IotronicAcademy/WRO-Future-Engineers-Mex-2025/schemes/Esquemas/Presentación1_01.png

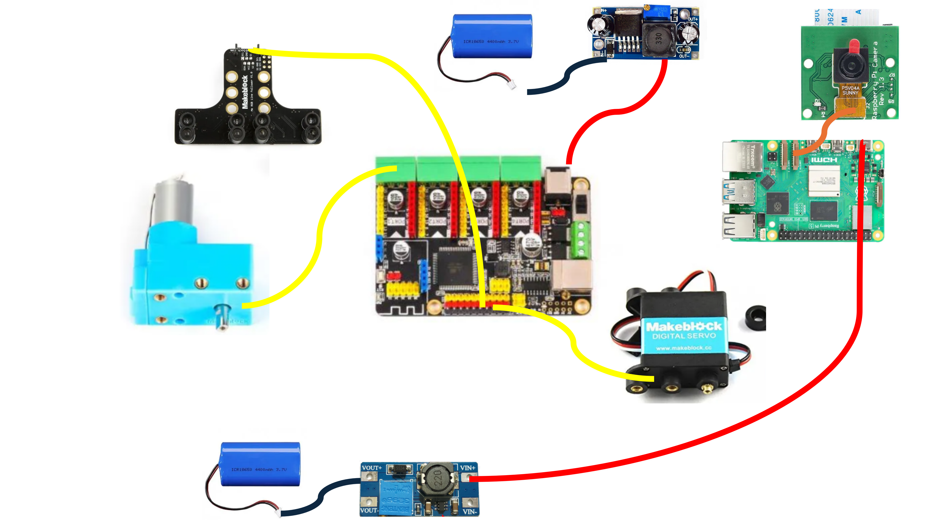
schemes/Esquemas/Presentación1_01.png
