IotronicAcademy/WRO-Future-Engineers-Mex-2025/t-photos/fun-team.jpg

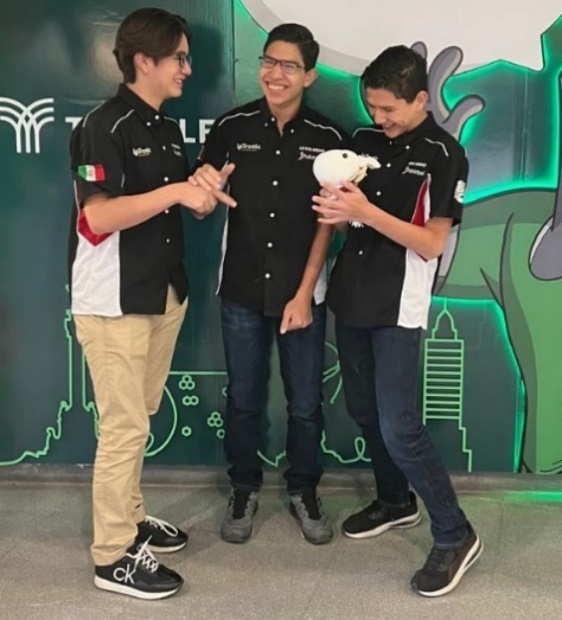
t-photos/fun-team.jpg
