IotronicAcademy/WRO-Future-Engineers-Mex-2025/t-photos/official-team.jpg

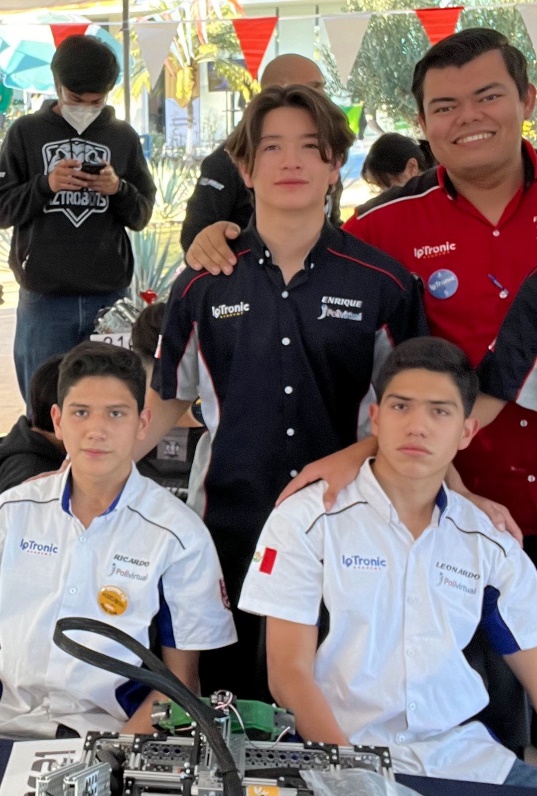
t-photos/official-team.jpg
