IotronicAcademy/WRO-Future-Engineers-Mex-2025/t-photos/team3.jpeg

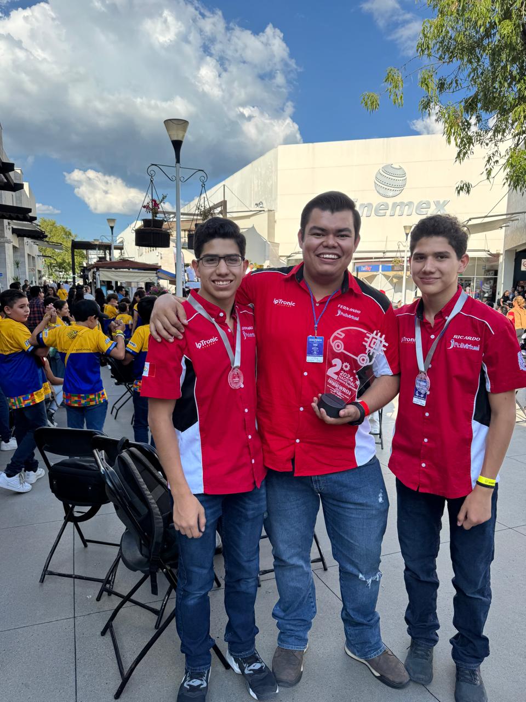
t-photos/team3.jpeg
