IotronicAcademy/WRO-Future-Engineers-Mex-2025/t-photos/team4.jpeg

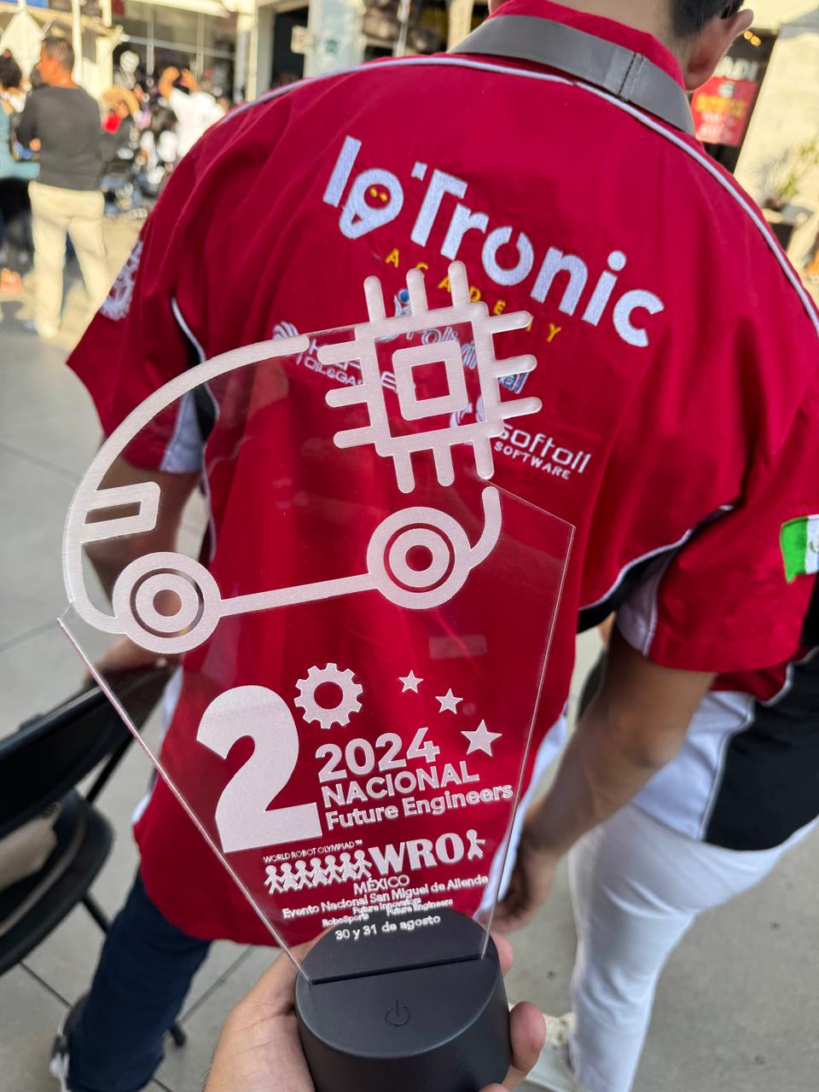
t-photos/team4.jpeg
