IotronicAcademy/WRO-Future-Engineers-Mex-2025/t-photos/team5.jpeg

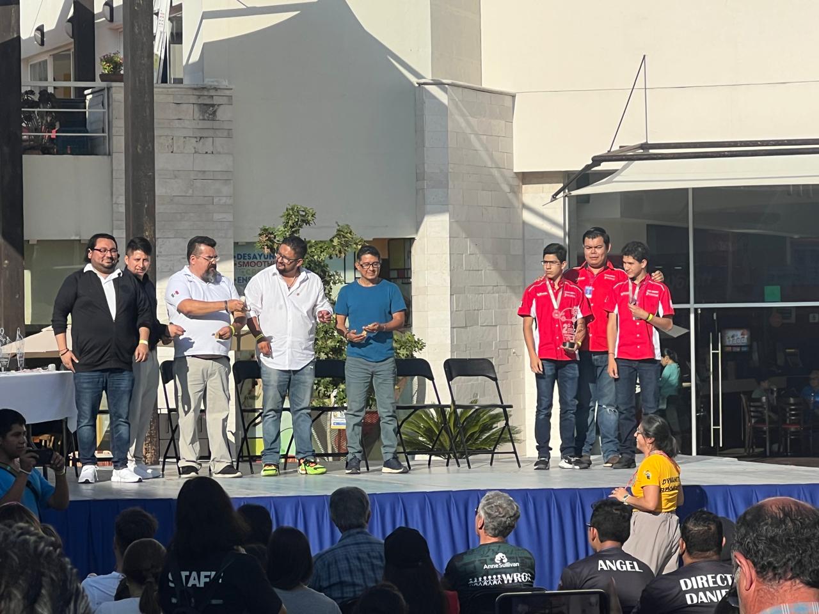
t-photos/team5.jpeg
