IotronicAcademy/WRO-Future-Engineers-Mex-2025/t-photos/team6.jpeg

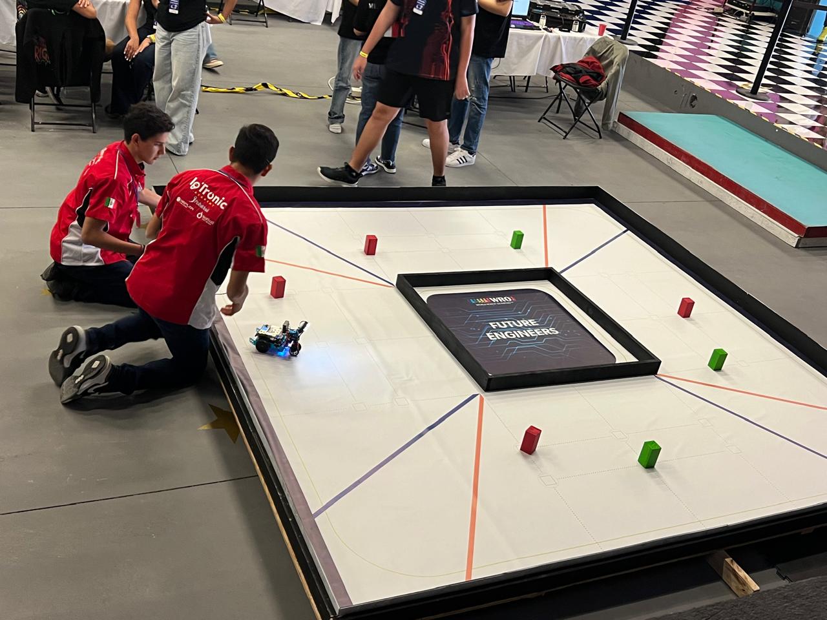
t-photos/team6.jpeg
