IotronicAcademy/WRO-Future-Engineers-Mex-2025/t-photos/team7.jpeg

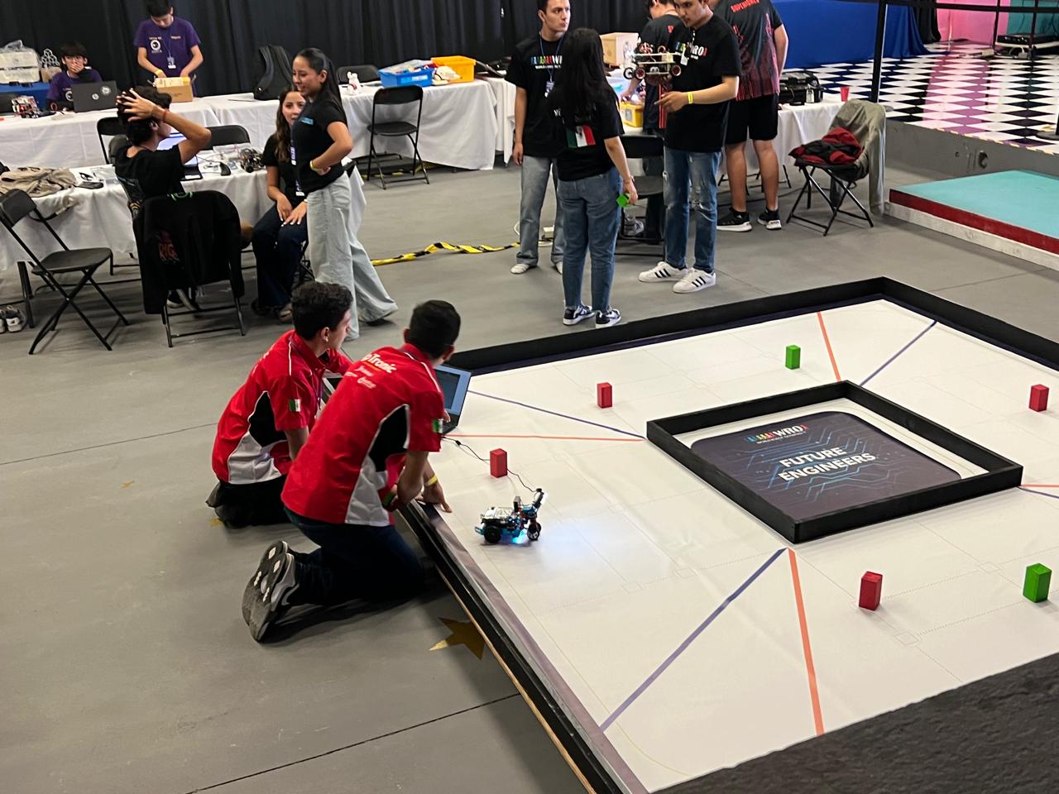
t-photos/team7.jpeg
