IotronicAcademy/WRO-Future-Engineers-Mex-2025/t-photos/team8.jpeg

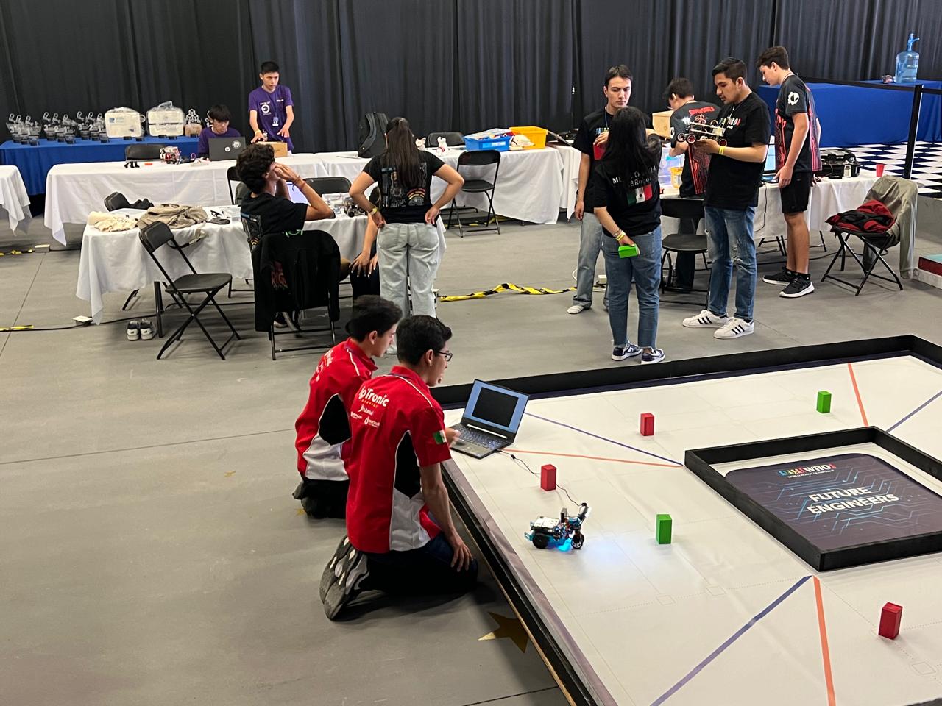
t-photos/team8.jpeg
