IotronicAcademy/WRO-Future-Engineers-Mex-2025/t-photos/team9.jpeg

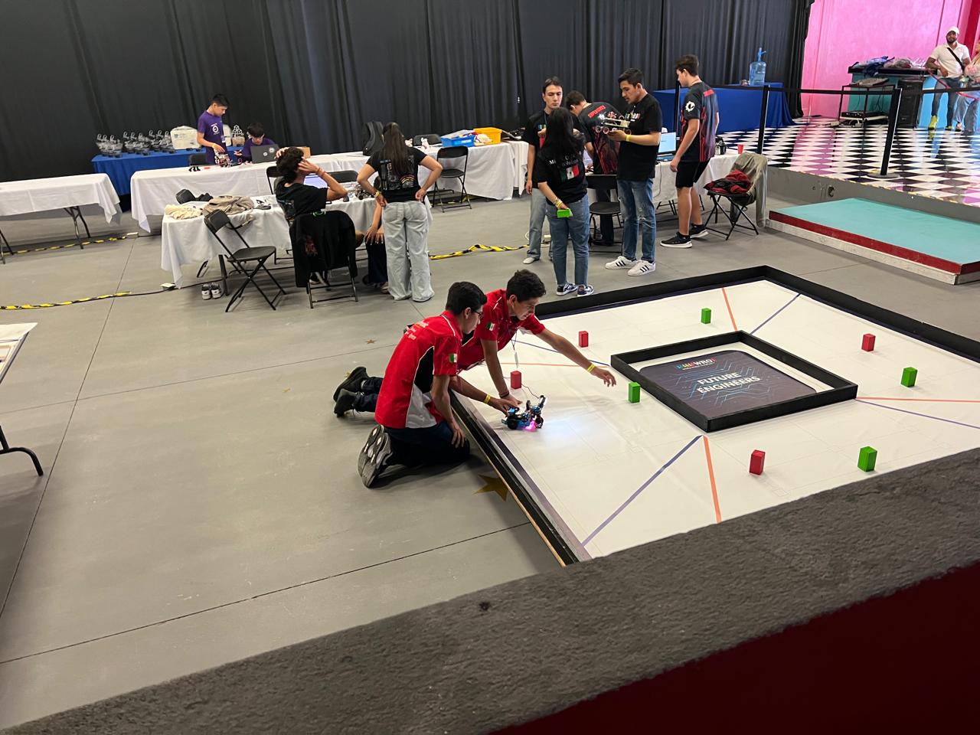
t-photos/team9.jpeg
