IotronicAcademy/WRO-Future-Engineers-Mex-2025/t-photos/team10.jpeg

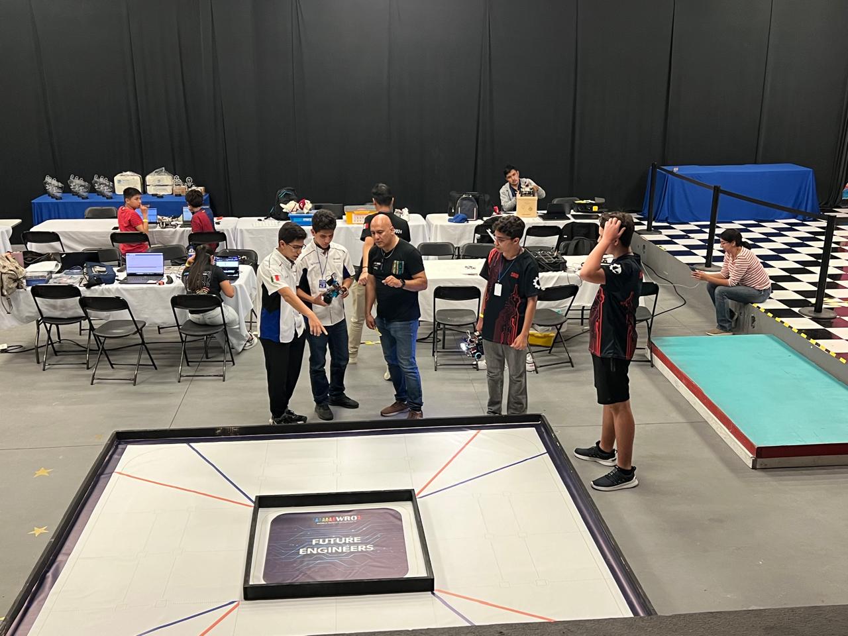
t-photos/team10.jpeg
