IotronicAcademy/WRO-Future-Engineers-Mex-2025/t-photos/team11 (1).jpeg

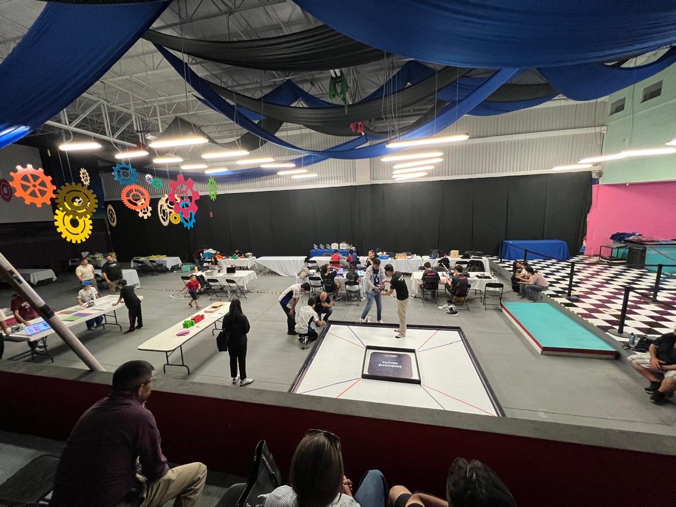
t-photos/team11 (1).jpeg
