IotronicAcademy/WRO-Future-Engineers-Mex-2025/t-photos/team11.jpeg

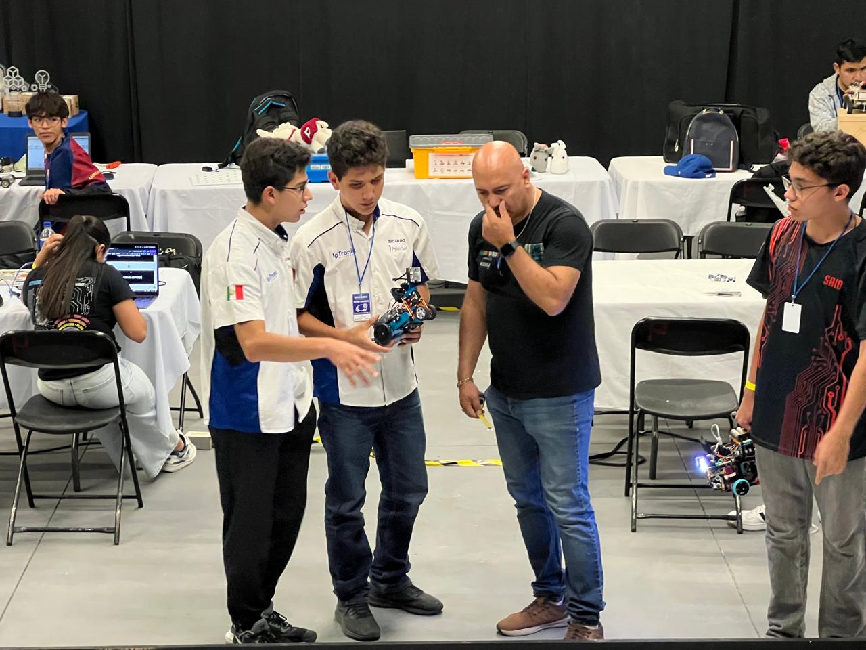
t-photos/team11.jpeg
