IotronicAcademy/WRO-Future-Engineers-Mex-2025/t-photos/team12.jpeg

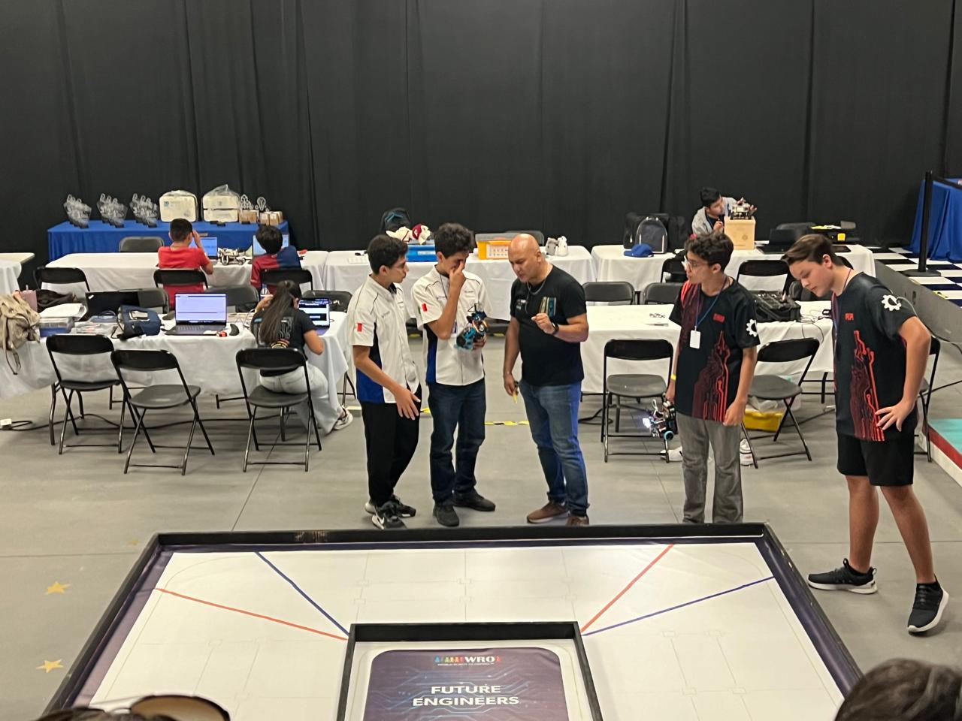
t-photos/team12.jpeg
