IotronicAcademy/WRO-Future-Engineers-Mex-2025/v-photos/Foto 2.jpg

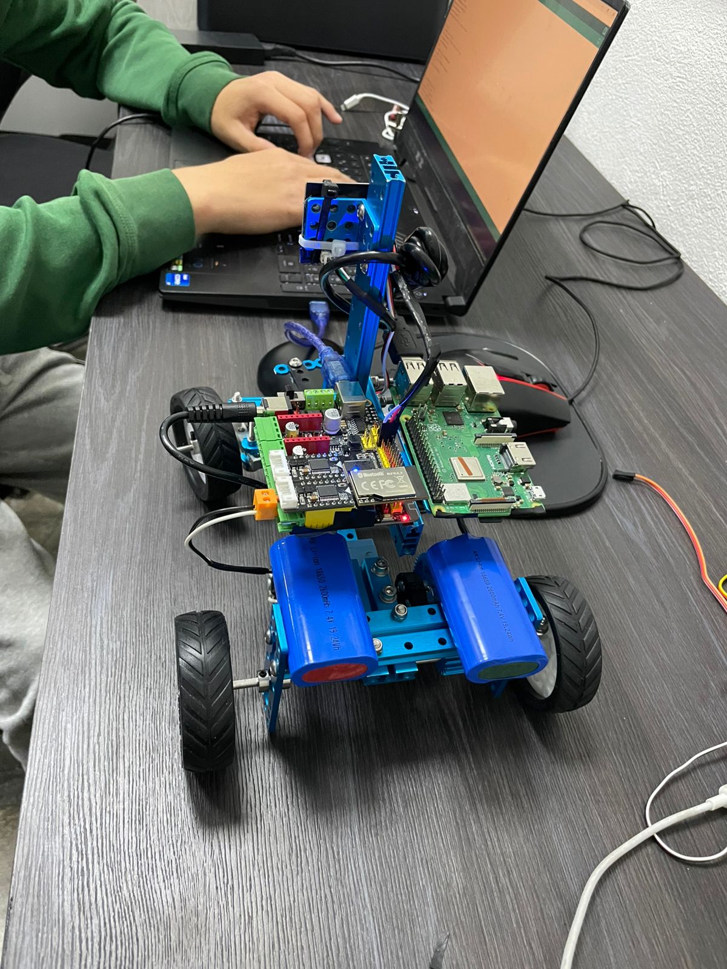
v-photos/Foto 2.jpg
