IotronicAcademy/WRO-Future-Engineers-Mex-2025/v-photos/Foto 3.jpg

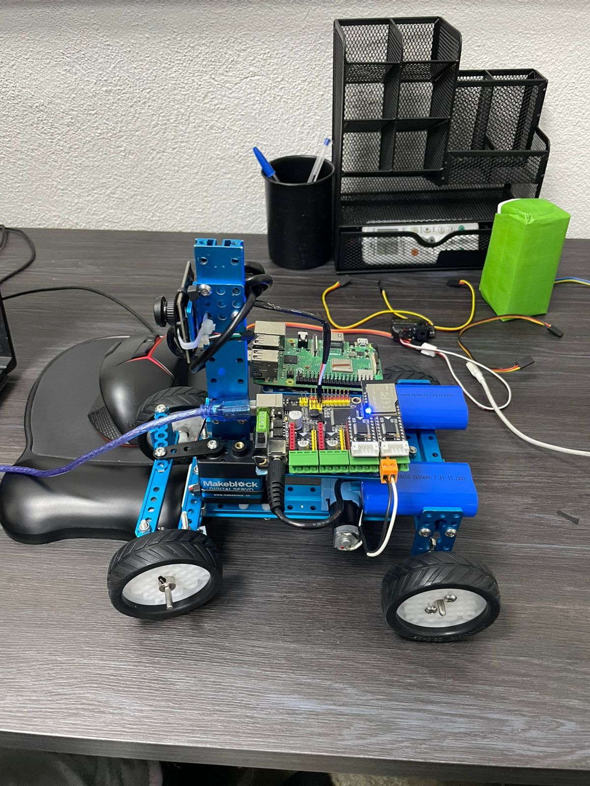
v-photos/Foto 3.jpg
