IotronicAcademy/WRO-Future-Engineers-Mex-2025/other/Engineering Journal/Engineering_Journal_IOTRONIC_Mexico_WRO_2025_RevF.pdf

TEAM: IoTronic Polivirtual - Leotronics ENGINEERING JOURNAL
WRO 2025
FUTURE ENGINEERS

SCHOOL: CECyT 9 IPN y Anáhuac Qro.

# ENGINEERING JOURNAL WORLD ROBOT OLYMPIAD FUTURE ENGINEERS

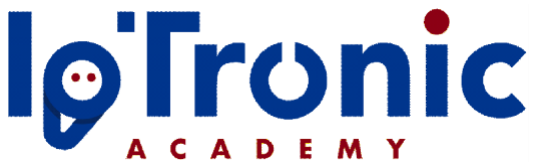
[picture p20: figure]

## TEAM NAME: IOTRONIC POLIVIRTUAL - LEOTRONICS

## TEAM CITY: QUERÉTARO, MÉXICO

## TEAM ACADEMY: IOTRONIC ACADEMY

TEAM SCHOOL: CECYT 9 IPN / ANÁHUAC QRO.

## COMPETITION PROGRAM: FUTURE ENGINEERS

## CAR NAME: GOAT L3 MEMBERS: 3

## ROSTER:

### - PROGRAMMER: LUIS RICARDO CHAVARRÍA ARREOLA - IPN

### - MECHANIC: LUIS LEONARDO CHAVARRÍA ARREOLA – IPN / ANÁHUAC

### - ELECTRONIC: LUIS ENRIQUE RAMÍREZ CHAVARRÍA - IPN

WRO 2025
FUTURE ENGINEERS

# TABLE OF CONTENTS

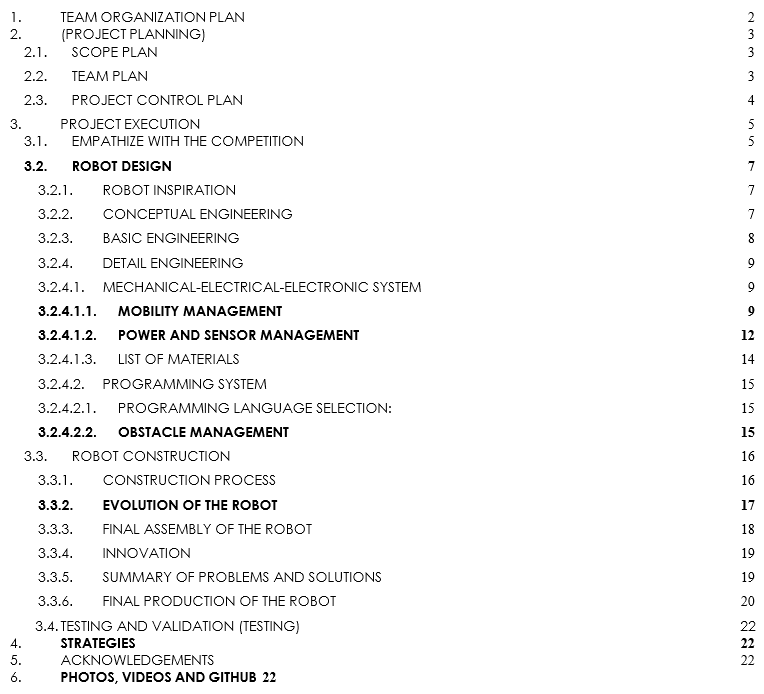
[picture p21: figure]
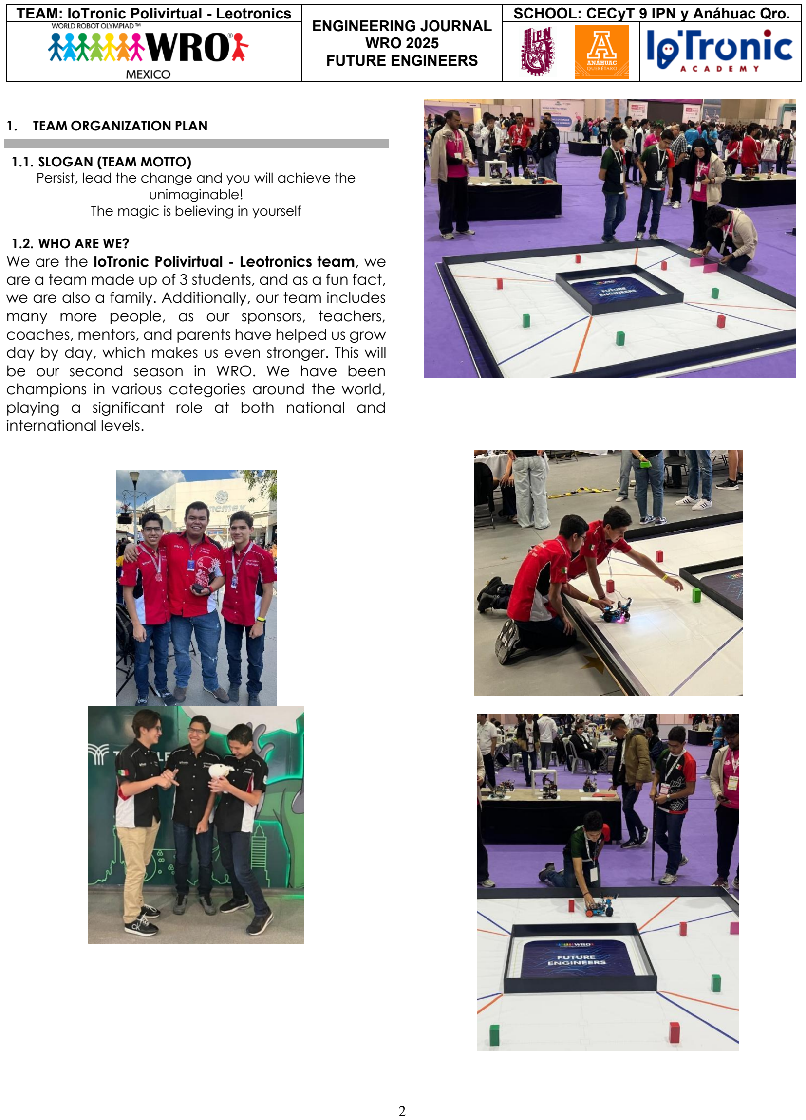
[picture p22: page 3]

WRO 2025
FUTURE ENGINEERS

### 1. TEAM ORGANIZATION PLAN

### 1.1. SLOGAN (TEAM MOTTO)

Persist, lead the change and you will achieve the unimaginable!
The magic is believing in yourself

### 1.2. WHO ARE WE?

We are the IoTronic Polivirtual - Leotronics team, we are a team made up of 3 students, and as a fun fact, we are also a family. Additionally, our team includes many more people, as our sponsors, teachers, coaches, mentors, and parents have helped us grow day by day, which makes us even stronger. This will be our second season in WRO. We have been champions in various categories around the world, playing a significant role at both national and international levels.

### 1.3. OBJECTIVES

Our objectives are:
- Learn: Learning is the number one foundation for achieving any objective, which is why we have studied, prepared ourselves, and acquired the tools to complement all our knowledge.
- Teach: We seek to teach others, especially about this world of STEAM, as it is essential to continue growing in what makes us happy.
- Inspire: We are not only seeking victory; just as we love to learn and teach, it goes hand in hand with inspiring others, especially the new teams in the STEAM community, showing them that it is possible. Everything you set your mind to can be achieved, that discipline and knowledge can be fun, and that everyone has the potential to win. We want to inspire people, students, Querétaro, all of Mexico, and make our team more than just a robotics team, but a movement of inspiration for all young people in the world.
2. (PROJECT PLANNING)

The Planning of this Project has 3 phases, which are: Scope Plan, Team Plan (Resources y Knowledge) and Project Control Plan.

### 2.1. SCOPE PLAN

In the Scope Plan, the following steps were determined: 1. Gather Requirements, 2. Define the Scope, 3. Create the Work Breakdown Structure

Scope definition: Construction of a robot with mechanical-electrical systems and programmable electronic systems to perform autonomous tasks on a competition track measuring 3.2 m x 3.2 m.

Work Breakdown Structure required for the project:

### 1. Empathize with the competition 2. Design 3. Build 4. Inspection and testing 5. Documentation

### 2.2. TEAM PLAN

Within the Team Plan, Resources and Knowledge Will be managed.

### 2.2.1. RESOURCE MANAGEMENT

Resource Management is classified into Human Resources, Technological Resources, and Material Resources.

- HUMAN RESOURCES– TEAM INTEGRATION

Everything started in September 2021, when my brother and I (Leonardo and Ricardo) saw a robotics tournament on television and told our dad that we liked watching the event and that one day we wanted to go to that type of tournament. After that my dad enrolled us in the Mexican School of Electricity so we could learn Basic Electricity and Electronics, and we trained every Saturday from September 4, 2021, to August 20, 2022. At the end of the course, my brother and I realized that we had developed technological skills, so we decided to create a team to compete in robotics.

My dad was searching for a Technology Coach and managed to find Fernando Juárez, who has experience in educational robotics tournaments. It’s worth mentioning that my dad is our Engineering Coach, and my mom is the Team Administrator, who has taken care of everything necessary (uniforms, a practice space, managing trips, and logistics in general) to prepare us for the competition.

In August 2023 we decided to invite our cousin Luis Enrique so he could participate with us, since his skills in electronic topics complement us.

The team was organized as follows: Robotics engineers:
- Luis Ricardo – Programming Technician
- Luis Leonardo – Mechanical Technician
- Luis Enrique – Electronics Technician Coaches
- Fernando Juárez – Robotics
- Luis Chavarria – Engineering Administration
- Deisy Arreola - Administration

Additionally, the participants will have the following administrative responsibilities:
- Luis Ricardo – Engineering Development
- Luis Leonardo – Project Planning and Control
- Luis Enrique – Development of the Testing Plan
- TECHNOLOGICAL RESOURCES

The following are the technological tools that were used and the associated activities:

Solid Works – Mechanical Design

Github – Code Control

Clickup – Project Control

MS Project – Project Timeline

MS Visio – Control Architecture

MS Excel – Calculation Reports

Micro Python Tonny - programming

- MATERIAL RESOURCES

We have facilities equipped with the material resources for the development of robotics projects.

At IOTRONIC Academy, which has a 3D Resin Printer, a 3D PLA Printer, a Laser Cutter, a Lathe, a Milling Machine, an Electronics Laboratory, and a WRO Competition Track.

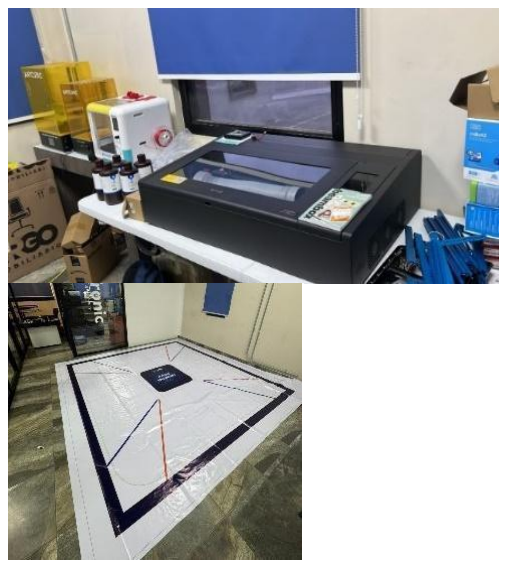
[picture p23: figure]

### 2.2.2. KNOWLEDGE MANAGEMENT

Knowledge Management covers the following activities:
1. Knowledge Assimilation (Research, Training, Coaching, Mentoring), 2. Knowledge Transfer (Knowledge Sharing, Lessons Learned), 3. Information Storage and Accessibility (Recording and Consultation), 4. Innovation (Incorporating Knowledge)

As part of Knowledge Assimilation, the following activities were used as Study Methods:
a) Research on Robotics Trends, WRO Competitions, Mobility Technologies, and Computer Vision Technologies.
b) Training in SolidWorks, Digital Systems, and Computer Vision.
c) Technological coaching
d) Competition mentoring
e) Watch videos of WRO tournaments. (YouTube)
f) Use WRO Future Engineers Getting Started
g) Use Q&A Forum WRO
As part of Knowledge transfer we conducted:
a) Interaction among team members
b) Work meetings
c) Lessons learned

As part of Information Storage and Accessibility, we use the IOTRONIC Drive.

### 2.3. PROJECT CONTROL PLAN

Within the Project Control Plan, the following phases are considered: 1. Define the Activities, 2. Sequence the Activities and Develop the Timeline, 3. Control the Project.

Defining the activities, sequencing the activities and developing the timeline:

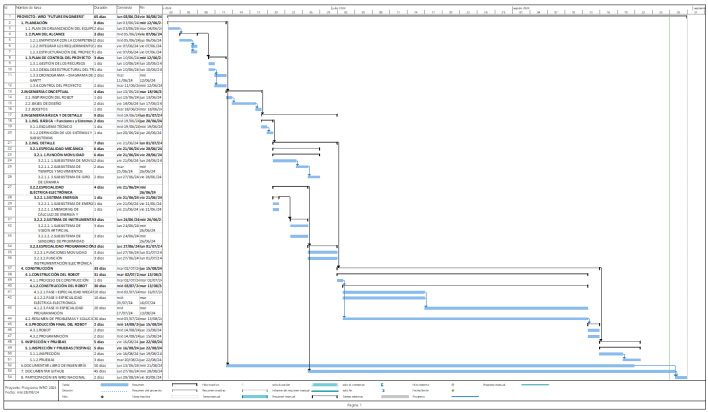
[picture p24: figure]

Project Control:
To ensure that a project is successful, it is important to have a comprehensive and detailed view of all project activities, especially the tasks and responsibilities of each person. For this, we use software that helps us maintain proper Project Control.

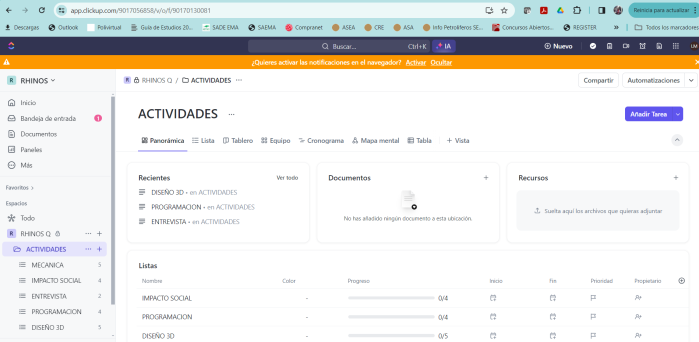
[picture p25: figure]

Commitment dates are established based on the work schedule, and deliverables are defined, which can be uploaded as files or images.

Project Documentation:
GitHub was used to document the project, and GitHub is an online platform that allows users to store, share, and collaborate on software projects. It is an open-source community that has become a hub for software development.
Among GitHub's features are:
- Store codes in repositories
- Share and present work
- Manage and track changes in the code
- Exchange code files
- Work on collaborative projects
- Establish professional relationships
- Crear un perfil y marca para promocionarse

GitHub is based on Git, a version control system that allows software developers to keep track of the changes made to the code.

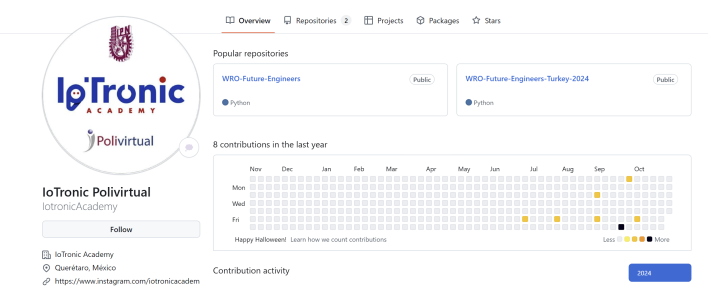
[picture p26: figure]
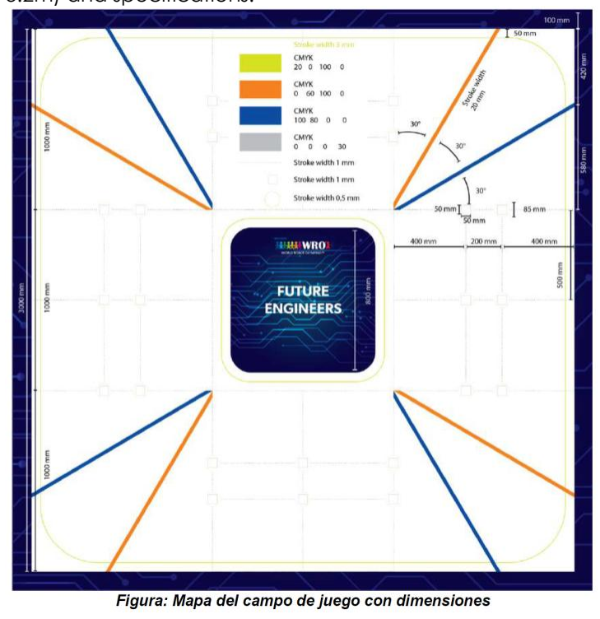
[picture p27: figure]

### 3. PROJECT EXECUTION

The Execution of this Project has 4 phases, which are: 1. Empathize with the Competition (Rules and Missions), 2. Robot Design (Conceptual Engineering, Basic Engineering, and Detail Engineering), 3. Robot Construction (Evolution of the Robot, Identifying Problems and Solutions, Final Production of the Robot), and 4. Inspection and Testing (Inspection and Testing)

### 3.1. EMPATHIZE WITH THE COMPETITION

In this phase, we must correctly understand the project's scope, the competition's objective, and its rules. The competition will be described next:

Missions/Challenges
The challenges for autonomous vehicles this season are Time Attack races: there will not be multiple cars on the track at the same time. Instead, one car will attempt to achieve the best time by completing several laps fully autonomously.

The two challenges are the following:
Open challenge: The vehicle has to complete three (3) laps on the track with random locations in the inner walls of the track.
Obstacle challenge: The vehicle has to complete three (3) laps in the track with randomly placed red and green traffic signals. The traffic signals indicate which side of the lane the vehicle should follow. The red pillar is the traffic signal to stay in the right side of the lane while the green pillar is the traffic signal to stay on the left side of the lane. The continuation of the vehicle to the third lap is indicated by the last traffic signal of the second lap. A green traffic signal indicates that the robot must proceed and continue the third lap in the same direction. A red traffic signal indicates that the vehicle must turn around and complete the third lap in the opposite direction. The vehicle must not move any of the traffic signals. After the robot completes the three laps, it must find the parking area and perform a parallel parking maneuver.

The initial direction in which the car must drive on the track (clockwise or counterclockwise) will vary in different challenge rounds. The initial position of the car, as well as the number and location of the traffic signals, are randomly defined before the round (after the verification time).

The competition is based on 2 Challenge Rounds: the Open Challenge will last 3 minutes, and the Obstacle Challenge will also last 3 minutes.

Track dimension
The competition track has the following dimensions (3.2m x 3.2m) and specifications:

Signaling
The track will also include the following traffic signals:

Playing field

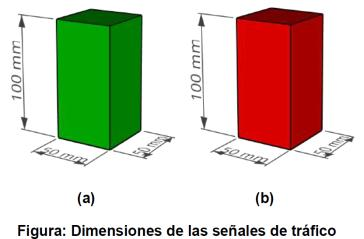
[picture p28: figure]

The following figure shows the playing field with the game objects

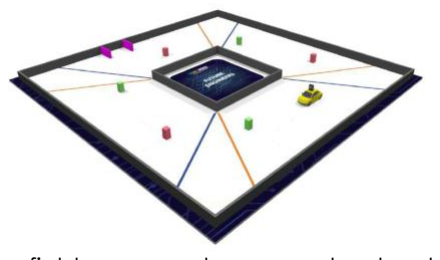
[picture p29: figure]

The playing field represents a racetrack where traffic signals (represented by colored obstacles - pillars) are placed. The track consists of eight sections: four corner sections and four straight sections.
The corner sections are marked with red dashed lines in the following figure.
The straight sections are marked with blue dashed lines.

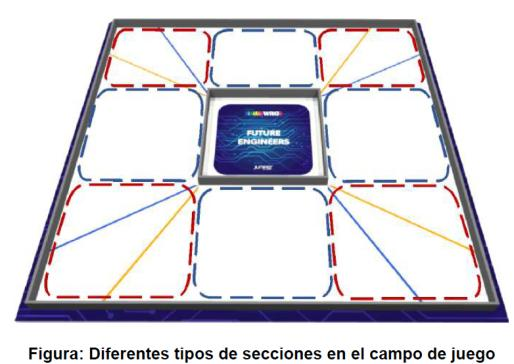
[picture p30: figure]

Each straight section is divided into 6 zones. The six internal zones within the section are for the starting position of the car. Four T-intersections and two X-intersections are used to position the traffic signals. The places where traffic signals

can | be | placed | are | called | traffic | signal | seats.

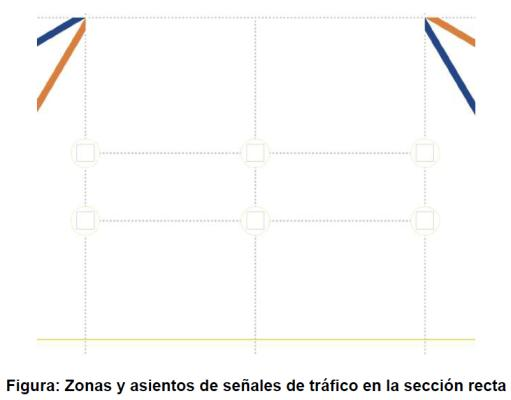
[picture p31: figure]

It is possible to place a parking area in one of the straight sections. The width of the parking area is always 20 cm. The length is variable and is calculated as 1.25 times the length of the robot.
The parking area is bounded by two wooden elements with dimensions of 20 cm x 2 cm x 10 cm in magenta. The right element is placed right next to the dashed line. The position of the left element is defined as described above..

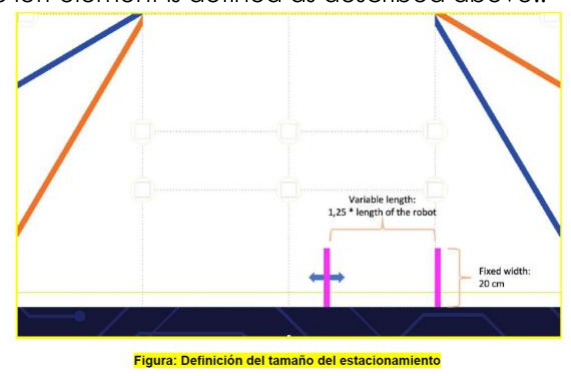
[picture p32: figure]

Scoring

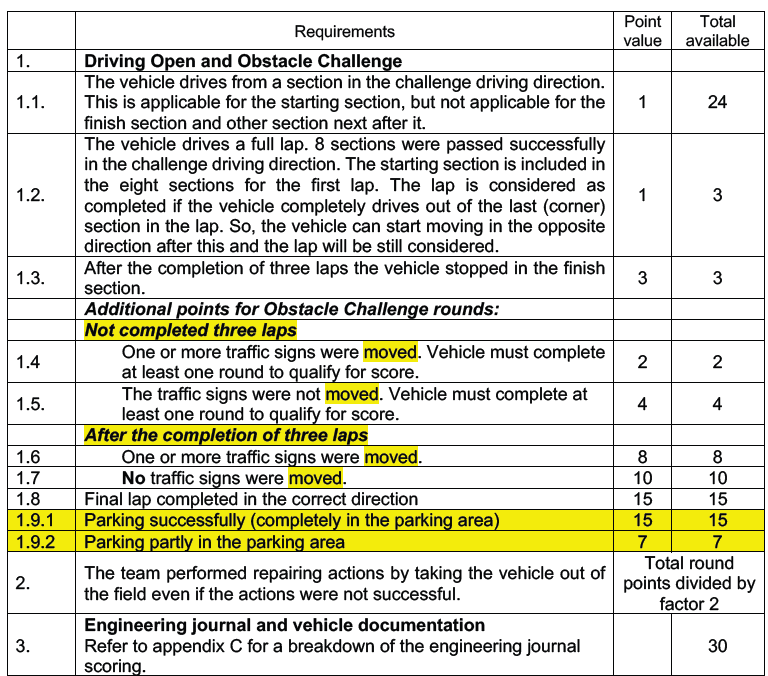
[picture p33: figure]

Practice and Verification Area
Within the competition, there will be practice time that can take place between rounds

After each practice time, there will be a vehicle verification period to check the requirements.

Each team must work during the practice time in their designated place until the verification time, at which point the team's vehicle must be placed in a designated area (verification area).

### 3.2. ROBOT DESIGN

To develop the design, a sequencing of activities must be carried out, starting with Robot Inspiration, followed by Conceptual Engineering, then Basic Engineering, and finally Detail Engineering.

In Conceptual Engineering the objective of the Project is defined and the Design Bases are established (which includes requirements, regulations, and the creation of sketches).

In Basic Engineering the design of the Mechanical-Electrical-Electronic System and the Programming System is developed.

In | the | Detail | Engineering | the | System | Integration
Architecture, Calculation Reports, and Programming are developed.

Both the Basic Engineering phase and the Detail Engineering phase are divided into the following functions:

- Mobility Management
- Power and Sensor Management
- Obstacle Management

Technical principles
The technical principles on which we develop our Robot are:
a) Mechanical: It is responsible for the accessories, parts, or mechanical equipment with which our main structure (chassis) will be built, as well as the complementary infrastructure that will serve the purpose of mobility.
b) Electrical: It is responsible for the dynamic equipment or motors that will enable the mechanical mobility functions. It also considers the type of electrical power supply and batteries.
c) Electronics: It is based on the sensors, cameras, or actuators that will be used to detect or activate mechanisms. It also considers the connections to the brain of the Robot (the processor) through the input and output ports.
d) Programming: It is based on the programming routine necessary for the Robot to perform specific tasks automatically to overcome obstacles.

### 3.2.1. ROBOT INSPIRATION

The name of our robot is “GOAT L3” and this name was inspired by our favorite cars.

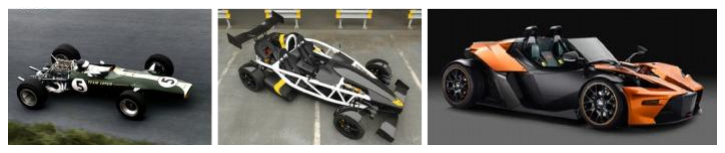
[picture p34: figure]

### 3.2.2. CONCEPTUAL ENGINEERING

The objective of the project is to build a Competition Robot for the FUTURE ENGINEERS Program.

### 3.2.2.1. Design bases

In this section, all regulatory constraints must be identified, which will serve as a basis for defining the Vehicle Design, taking into account the requirements of the missions. The identification of the constraints will be carried out in 2 Systems: 1. Mechanical-Electrical-Electronic Design and 2. Programming Design.

### 1. Mechanical-Electrical-Electronic System Design: only 3D

printed elements, elements prepared with a CNC machine, elements cut from acrylic/wood/metal, or any element made of any material may be used. The following must be met:"

- The dimensions of the vehicle must not exceed 300x200 mm and 300 mm in height.
- The weight of the vehicle must not exceed 1.5 kilograms.
- The vehicle must be a 4-wheeled vehicle with a drive axle and a steering actuator of any type. It must be front-wheel drive, rear-wheel drive, or all-wheel drive. Vehicles with a differential wheel base are not allowed.
- The use of omnidirectional wheels or spherical wheels is not allowed
- The vehicle must be autonomous and complete the 'missions' on its own. Radio communication systems, remote control, or wired control systems are not allowed while the vehicle is in operation.
- DC electric motors and/or servos from any brand may be used.
- A maximum of two motors is allowed to make the vehicle move forward or backward (i.e., to drive the robot; these are the drive motors). The drive motors must be connected directly to the axle that rotates the wheels or indirectly through a gear system. The two drive motors cannot be independently connected to the drive wheels.
- Teams may use any battery of their choice; there are no restrictions on the brand, function, or number of batteries used.

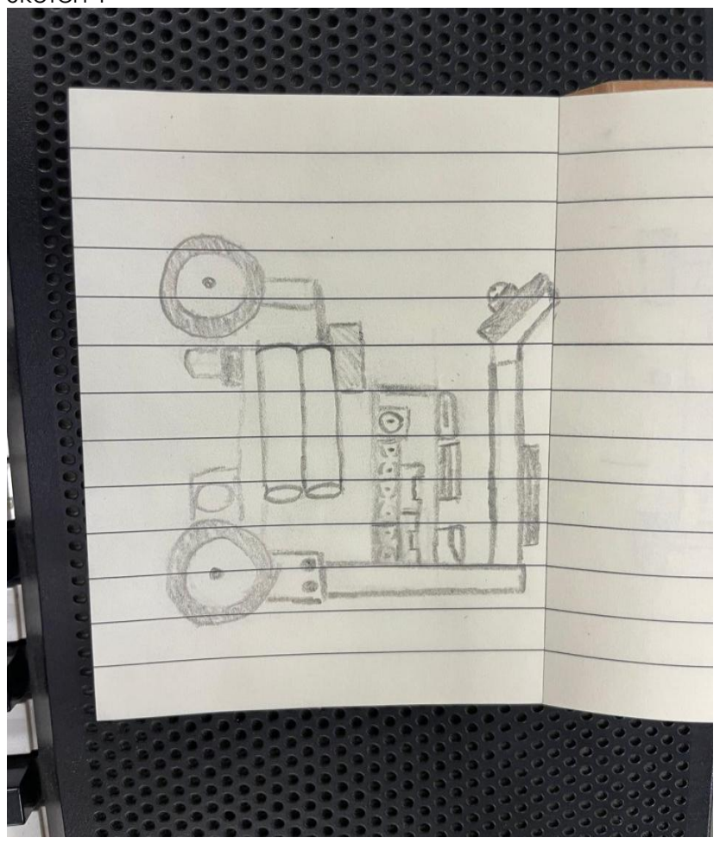
[picture p35: figure]

Regarding the Controllers, Sensors, Cameras, Encoders, and Actuators allowed in the FUTURE ENGINEERS regulations.

- Sensors of any brand, function, or quantity may be used.
- Teams may use any electronic component; there are no restrictions on type, brand, quantity, or purpose.

### 2. Programming Design: any programming language may

be used. The following must be met:
- An SBC or SBM may be used without brand restrictions
- There may be more than one SBC/SBM in the vehicle.

### 3.2.2.2. Regulations – Robot Specifications

Size | Requirements
Maximum | 30 cm long 20 cm wide 30 cm high
Weight | Requirements
Maximum | 1.5 kilograms

### 3.2.2.3. Conceptual Design with SKETCHES:

Sketch 1

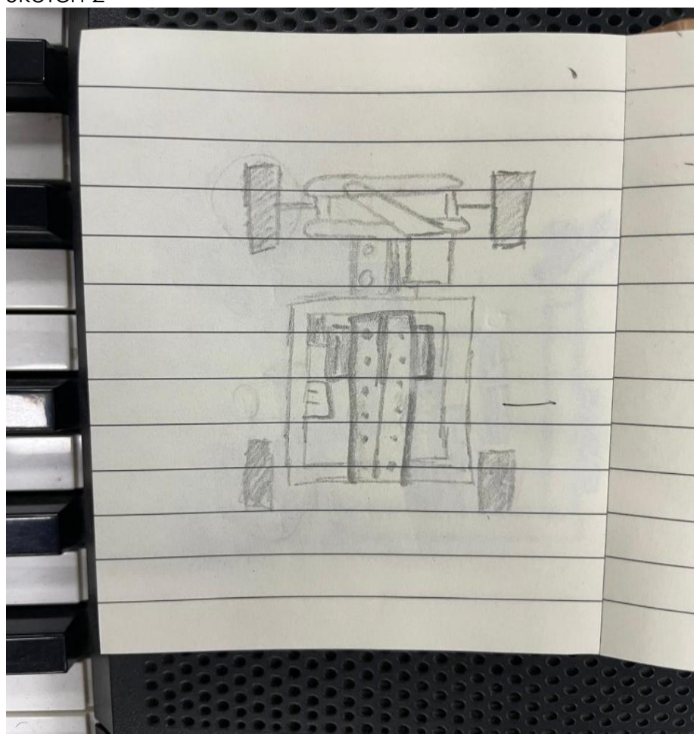
[picture p36: figure]

Sketch 2

### 3.2.3. BASIC ENGINEERING

As part of Basic Engineering, the specifications of materials and equipment will be integrated, both in the Mechanical-Electrical-Electronic System and in the Programming System.

The design intention of the Robot consists of 7 subsystems grouped into 3 Management Functions and 2 Systems, which are:

### 1. Mechanical-Electrical-Electronic System

1) Mobility Management Function
- Mechanical Structure Subsystem
- Mobility Subsystem with Electric Motors
2) Power and Sensor Management Function
- Power Supply Subsystem
- Electronic Sensors Subsystem
- Camera Subsystem
- Control Subsystem

### 2. Programming System

3) Obstacle Management Function
- Programming Subsystem
- Open Challenge Strategy
- Obstacle Challenge Strategy

Describing the Subsystems
- Mechanical Structure Subsystem: The objective is to
develop | the | Robot's | chassis, | complementary
infrastructure, and the implementation of 4 wheels.
- Mobility Subsystem with Electric Motors: The objective is to program movements based on activity times.
- Power Supply Subsystem: The objective is to provide electrical power to all motors, sensors, and the camera.
- Proximity Sensors Subsystem: The objective is to have sensors for line detection and obstacle proximity.
- Camera Subsystem: The objective is to have a camera for object and color identification.
- Control Subsystem: The objective is to have an Embedded Control System where the programming codes will be stored.
- Programming Subsystem: The objective is to have programming to execute the missions and strategies for the Open Challenge and the Obstacle Challenge.

3.2.4.
DETAIL | ENGINEERING

As part of Detail Engineering, calculation reports and designs were generated for the Mechanical-Electrical-
Electronic | System | and | the | Programming | System.

Our philosophy for building the Robot in 2025 took into
account | 3 | essential | points:
1. Selecting modern technologies that allow high computational performance and reliable integration.
2. Innovating the design by improving energy distribution
and | motor | performance.
3. Avoiding the use of pre-designed kits and focusing on
custom | solutions.
CONTROL | SUBSYSTEM

For this season, the control system was completely upgraded:

- Raspberry Pi 5 was selected as the Master Controller, responsible for computer vision, image processing, and decision-making.
- MegaPi board was selected as the Slave Controller, responsible for controlling motors, sensors, and actuators.
- Communication between Raspberry Pi 5 and MegaPi is
established | via | Serial | UART | (Master–Slave).
- Raspberry Pi Camera 2 was integrated into the Raspberry
Pi | 5 | for | real-time | color | and | object | detection.
- An aluminum heat sink was installed on the Raspberry Pi 5 processor to prevent overheating during intensive image
processing | tasks.

The control architecture was updated for 2025: Raspberry Pi 5 acts as the Master Controller handling vision and decision-making, while MegaPi functions as the Slave
Controller | managing | actuators | and | sensors. | They
communicate via serial UART. An aluminum heat sink ensures the Raspberry Pi 5 maintains thermal stability during high processing workloads.

As part of Detail Engineering, calculation reports and designs were generated for the Mechanical-Electrical-Electronic System and the Programming System.

Introductively, we can say that our philosophy for building the Robot took into account 3 essential points:

1. Considering different technologies in the market to achieve a rapid integration of the robot's structure. For this, MakeBlock and custom technologies were taken as references.

### 2. Innovate the design by modifying motors (removing and

adding gears to adjust speed), designing mechanical elements, and printing them in 3D.

### 3. Do not use complete kits with pre-designed mechanisms

or codes.

### 3.2.4.1. MECHANICAL-ELECTRICAL-ELECTRONIC SYSTEM

This system will detail the design of Mobility Management and Energy and Sensor Management.

### 3.2.4.1.1. MOBILITY MANAGEMENT

In this section, we will describe how the robot's structure was designed, the design of the wheels, how motors were selected, the list of materials, and calculation reports to determine speed, distance, and torque.

### 3.2.4.1.1.1. Mechanical Structure Subsystem (Chassis

and Wheels)
The Robot's structure was integrated based on what was described in the Robot Inspiration section, using the chassis and wheels from the MakeBlock Robot as a reference.

Design of the Chassis: The chassis is made of aluminum and was designed with dimensions of 16 cm wide x 23.5 cm long x 20 cm high, with a thickness of 2 cm. This chassis will house the Controller, Sensors, battery, and rear wheels.

Design of the wheels: The wheels are designed with a plastic rim and a polyurethane tire, and the size varies between front and rear wheels due to the speed and torque required.
hf
Wheels are a fundamental component in mobile robots, as they provide the necessary traction for movement. The size of the wheels is an important factor that affects the speed, energy efficiency, ground clearance, and traction of the robot.
Larger wheels require more torque to turn, but can move faster and overcome more obstacles. On the other hand, smaller wheels need less torque, but have lower speed and ground clearance.
The rear wheels are designed with a 6.5 cm plastic rim and a tire that is 2.5 cm thick.

The size of the front wheels is considered to be smaller in diameter than the rear wheels because the robot has front-wheel drive and requires more precision in its movements.

Design | of | Complementary | Infrastructure: | Since
infrastructure is required to support the front wheels, a custom mechanism was used as a reference.

And for the infrastructure that supports the camera and
sensors, | a | mechanism | was | designed | integrating
components from Makeblock and custom.

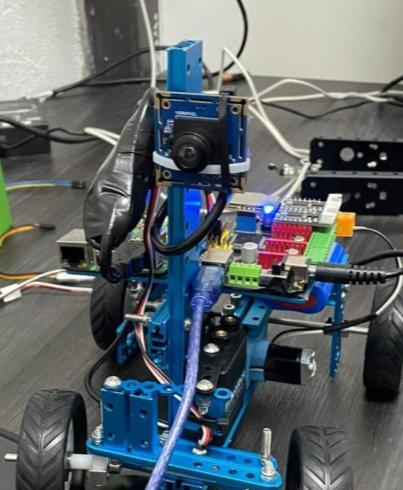
[picture p37: figure]

### 3.2.4.1.1.2. Mobility Subsystem with Electric Motor

As part of the design, it was necessary to evaluate the different types of motors available for educational robotics applications in order to make an appropriate selection.

Selecting the appropriate motors for a robot is crucial to achieving precise and efficient movements.

Below are six key criteria for selecting motors for this type of robot.

1. Torque
- The maximum weight that the robot must support (which is 1.5 kg) is determined. Then, a motor is chosen that can handle at least this load capacity, with a certain safety margin.

2. Maximum acceleration
- The higher the gear ratio of the reducer, the greater the maximum acceleration of the motor. Therefore, a target speed must be defined, and the motor with the appropriate characteristics should be selected.

3.Speed
- The speed of the motors will affect the movement capabilities of the robot. Depending on the application, you may need to balance high-speed movements for quick actions or slower speeds for more precise tasks.
- The motor must also be able to maintain a constant speed throughout its range of motion to ensure accurate and precise movements.
4. Precision and accuracy
- Precise and accurate movements are essential, and motors with high precision will ensure that the robot can reliably repeat tasks. However, precision should not be overestimated, as it will impact the cost.

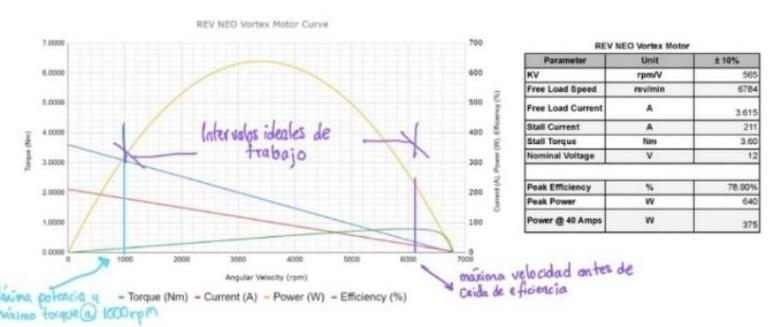
[picture p38: figure]

5.Energy efficiency
- Low-power motors will help extend the robot's battery life, reducing the frequency of recharges during operation.

6.Motor type and drive
- There are DC motors, DC geared motors, DC geared motors with encoders, servo motors, brushless motors, and stepper motors. Each of these has unique characteristics that make them suitable for specific applications.

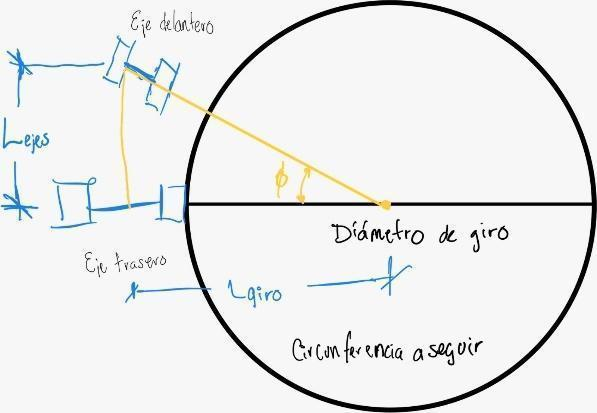
[picture p39: figure]

Below is a comparative evaluation matrix for motors used in educational robotics applications:

MOTOR SELECTION
After analyzing and evaluating the motors, it was determined that a DC geared motor will be used for the mobility of the wheels and a servo motor for the steering.

DC Geared Motor with Encoder

SERVOMOTOR

CALCULATION RECORDS

Distance Traveled per Wheel

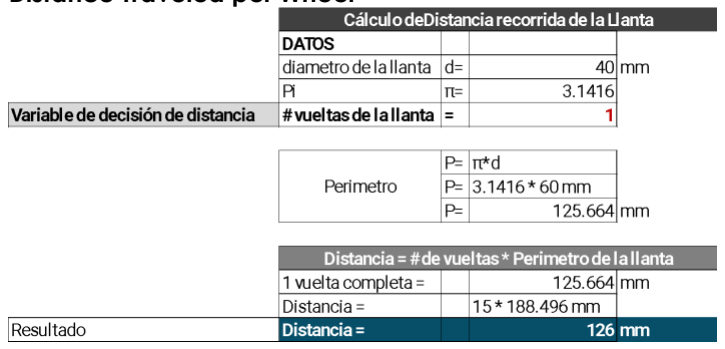
[picture p40: figure]

Torque

Turning Calculation Record

### 3.2.4.1.2. POWER AND SENSOR MANAGEMENT

The power system was redesigned to ensure stability and autonomy:

- Two independent 7V lithium batteries are used.
* Battery 1 supplies power to the Raspberry Pi 5 and the camera.
* Battery 2 supplies power to the MegaPi, motors, and sensors.
- Voltage regulators were implemented to stabilize and equalize the voltage for each subsystem, following manufacturer recommendations.
- Sensors integrated into the MegaPi include Gyroscope, Ultrasonic, IR, and RGB sensors. These provide data to the Raspberry Pi 5, which processes them for decision-making.

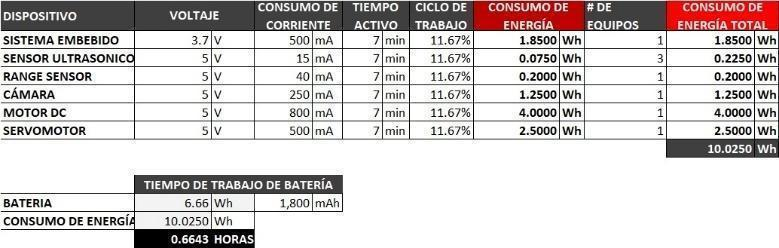
[picture p41: figure]

In this section, the battery, sensors, camera to be used, and embedded system will be selected. Additionally, a calculation record for electrical loads, a materials list, a wiring diagram, and a control architecture will be created.

### 3.2.4.1.2.1. Power Supply Subsystem

In this section, the battery will be selected, and the energy consumption and power will be calculated.

Battery Selection: The pros and cons of the batteries will be
stated, | along | with | their | characteristics, | and | the
appropriate battery for the robot will be selected.

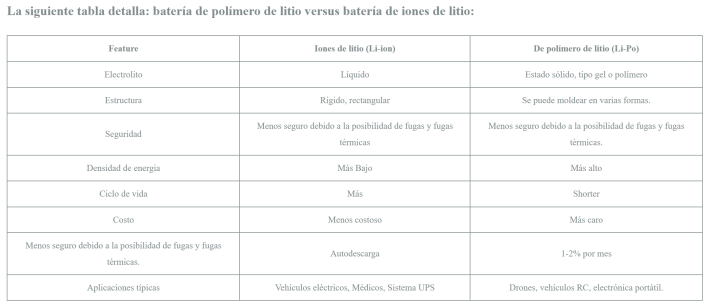
[picture p42: figure]

Energy and Power Calculation Record

### 3.2.4.1.2.2. Electronic Sensors Subsystem

Sensor selection: the sensors used in MakeBlock will be listed, and a selection will be made.

The sensors on the MegaPi board include a RGB Sensor, which can be used to map the robot's location.

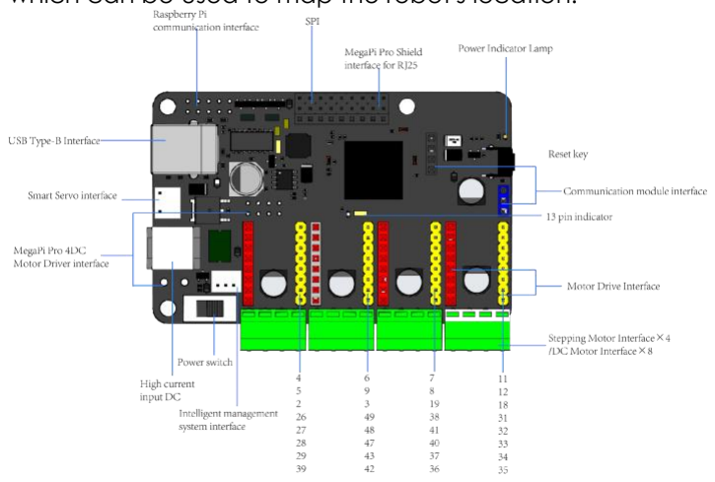
[picture p43: figure]
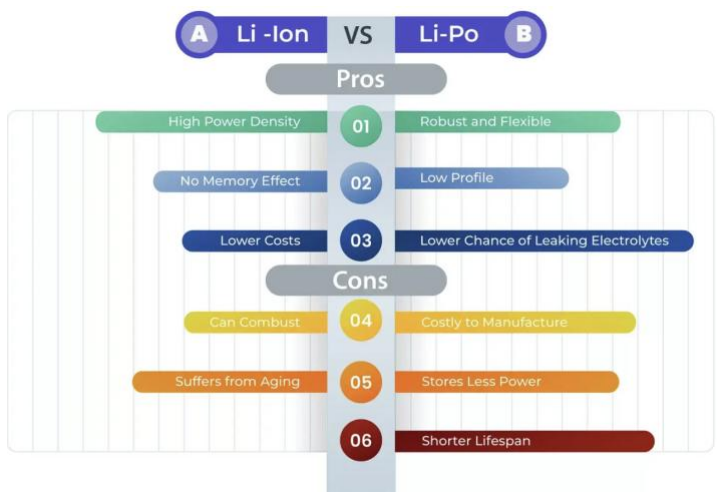
[picture p44: figure]

Additionally, the sensor kit that can be used includes the Ultrasonic Sensor, RGB Sensor, IR Sensor, and PIR Sensor.

Ultrasonic Sensor(Proximity)

IR Sensor(Proximity)

RGB Sensor(Line detector, color)

PIR Sensor (People detector)

The selected sensors are:
- RGB Sensor

Additionally, a Raspberry Pi 5 card was integrated to connect to the camera and execute the Artificial Vision processing.

### 3.2.4.1.2.3. Camera Subsystem

In this section, the camera to be used will be selected, and the field of view to be used with the camera will be determined.

Camera Selection: There are cameras for computer vision applications with an educational focus that can be installed on Raspberry Pi, MegaPi, LEGO, and mBot.

Field of View Calculation Record:

The maximum field of view is shown in the previous figure, but a shorter range can be configured, which can improve detection accuracy. Therefore, a range of 30% of the maximum value was defined

### 3.2.4.1.2.4. Control Subsystem

In this section, the embedded system to be used will be selected, the wiring diagram of the embedded system will be created, the board design will be shown, and the control system architecture will be developed

Selection of the Embedded System (Controller): Although there are various embedded systems, we will only analyze 3 which are Raspberry, MegaPi and mBot (Raspberry Pi 5).

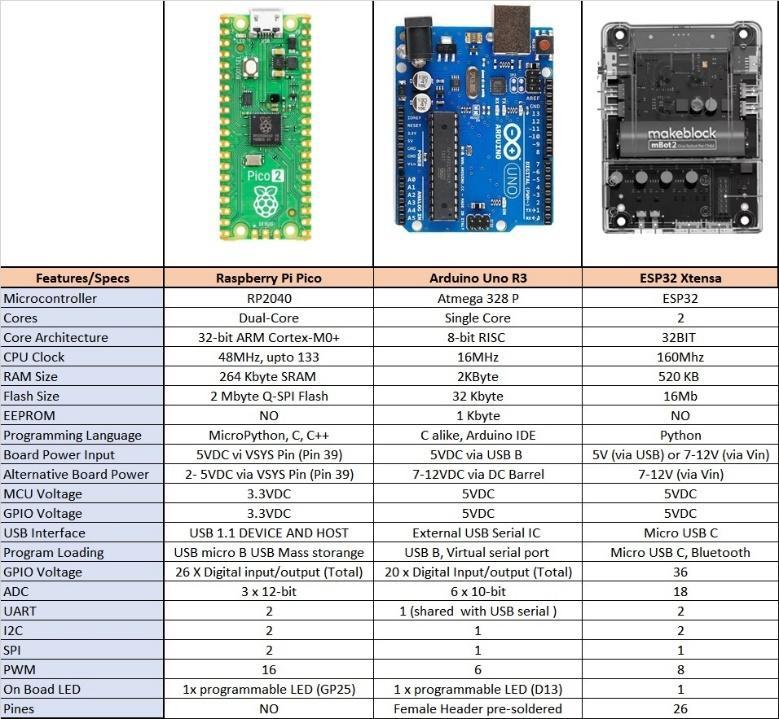
[picture p45: figure]

After analyzing the table, it can be seen that the 3 embedded systems have the capacity to face the challenges of the challenges, but... one of the characteristics of the Raspberry Pi 5 + MegaPi is that it can be programmed in blocks (which through commands can have access to simplify routines) and in the case of using the mbot camera, then the preconfigured functions of artificial vision can be maximized. For this reason, Raspberry Pi 5 + MegaPi was selected as the Controller. For this reason, Raspberry Pi 5 + MegaPi was selected as the controller.

The Wiring Diagram for the Raspberry Pi 5 + MegaPi Embedded System was developed in Visio:

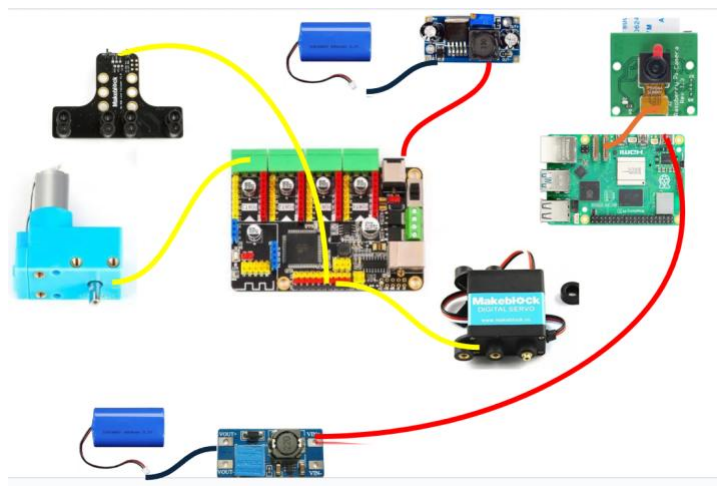
[picture p46: figure]

### 3.2.4.1.3. LIST OF MATERIALS:

Next, the list of Mechanical, Electrical, and Electronic materials will be presented.

- Aluminum Chasis
- Raspberry
- MeogaPi
- RGB Sensor
- Dc Motor
- Servo Motor

### 3.2.4.2. PROGRAMMING SYSTEM

For the 2025 season, programming was migrated from MicroPython-based coding to MicroPython:

- Programming Language: MicroPython
- Development Environment: Thonny IDE
- Raspberry Pi 5 executes all computer vision tasks using Python libraries such as OpenCV.
- MegaPi receives serial commands from the Raspberry Pi 5 and executes motor and actuator control.

This architecture allows separation of tasks: Raspberry Pi 5 handles vision and strategy, while MegaPi manages low-level control.

Note: For WRO 2025, the robot was fully migrated to MicroPython using Thonny IDE. This allows direct Python programming on the Raspberry Pi 5, which executes computer vision tasks and communicates with the MegaPi through serial UART for motor and sensor control.
In this section, the programming language will be selected, the programming environment will be defined, and the programming algorithm will be developed.

### 3.2.4.2.1. PROGRAMMING LANGUAGE SELECTION:

### 1. Thonny IDE with MicroPython

A graphical programming software based on MicroPython 2.0 that can be installed on a computer. The free app for Chrome, as well as the app for Android or iOS, or the Bluetooth module that attaches to the robot can also be used.

### 2. Python

A more demanding programming language, but flexible and comprehensive, suitable for more advanced users.

It is worth mentioning that, although programming is done in Thonny IDE with MicroPython, the coding can be viewed in Python. Since Thonny IDE with MicroPython has commands that combine coding sequences in Python, it was decided to select Thonny IDE with MicroPython for efficiency, but the documentation on GitHub was created in Python

### 3.2.4.2.2. OBSTACLE MANAGEMENT

The obstacle management strategy now incorporates
advanced | control | algorithms:
- A PID controller is implemented for color detection, ensuring smooth corrective actions when detecting track
limits, | | signals, | and | | obstacles.
- Raspberry Pi 5 processes images from the Camera 2,
applies | vision | algorithms, | and | makes | decisions.
- MegaPi executes the movement commands received via
serial | communication.

This configuration ensures improved accuracy, stability, and collision avoidance during the Open Challenge and Obstacle Challenge.

In this section, Artificial Vision will be described as a programming tool, and the programming algorithms for the challenges will be presented.

Artificial vision is an interdisciplinary scientific field that studies how computers can gain high-level understanding from digital images or videos. From an engineering perspective, it seeks to understand and automate tasks that the human visual system can perform.

### 3.2.4.2.2.1. Challenge Programming Subsystem

In this subsystem, the Philosophy of the Challenge Strategy, the Programming Algorithms, and the Programming Tools used are integrated

CHALLENGE STRATEGY
Open Challenge Strategy: The strategy involves using proximity sensors to locate the limiting walls and using line sensors to control the robot's turning.

Obstacle Challenge Strategy: The strategy involves using proximity sensors to locate the limiting walls and using a camera for obstacle and color recognition to enable the robot to change direction and identify parking spots to park itself.

PROGRAMMING ALGORITHMS
Programming Algorithms:
Next, the algorithm for the Open Challenge Strategy will be presented:

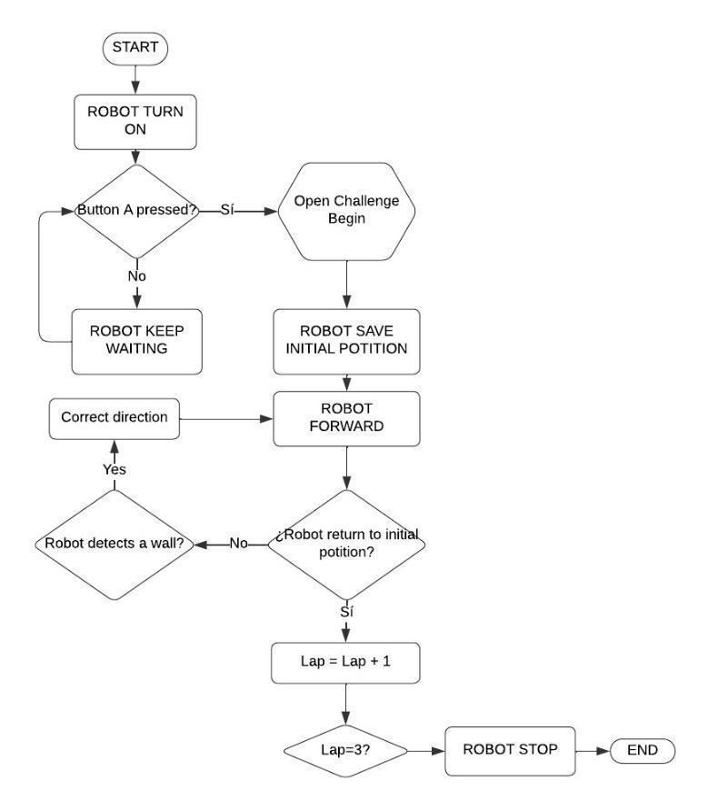
[picture p47: figure]

Now, the algorithm for the Obstacle Challenge Strategy will be presented:"

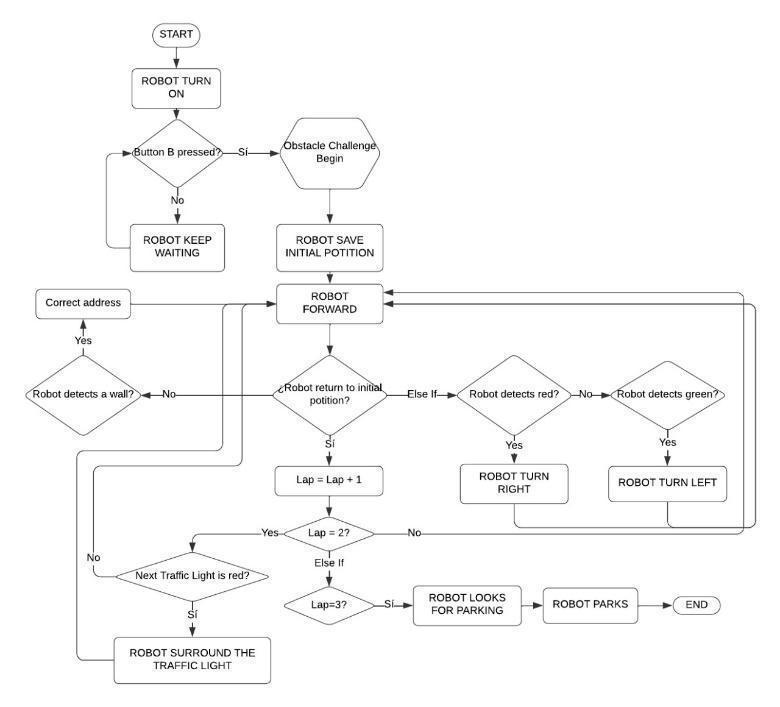
[picture p48: figure]

PROGRAMMING TOOLS USED
The following programming technologies were used: PID, Artificial Vision, Discrete Control, Times and movements.

### 3.3. ROBOT CONSTRUCTION

In this phase of the project, the robot must be constructed according to the established design. This involves assembling the robot, coding, problem detection, finding solutions, and refining the robot to achieve the Final Production of the Robot.

### 3.3.1. CONSTRUCTION PROCESS

Assembling the robot was very exciting, as my cousin, my brother, and I learned a lot and had fun. We spent many Saturdays eating pizza, sandwiches, tacos, and soda; on a couple of occasions, we stayed up late working on the assembly because we didn’t even notice the passage of time.

Our robot went through 4 phases of construction evolution, and in each phase, we encountered errors or challenges that we had to address, which allowed us to continuously improve the robot.

The assembly process was carried out in the following 4 phases:

Phase I – Assembly of the Mobility Management System -Mechanical
Base Mechanical Structure (Chassis)
- Assembly of the robot's base structure
- Assembly of the wheels
Complementary Mechanical Structure
- Structure to support the camera and sensors

Phase II – Assembly of the Energy Management System -Electrical
- Installation of the battery
- Installation of the motors

Phase III – Assembly of the Sensor and Actuator Management System - Electronics
- Installation of the Controller
- Installation of the Cameras and Sensors

Phase IV – Obstacle Management - Robot Programming
- 1st Round
- 2nd Round

### 3.3.2. EVOLUTION OF THE ROBOT

It starts with prototypes and is refined through constant evolution.

MECHANICAL PROTOTYPES
We started with various prototypes that didn't always work, or at least not as we desired, which led us to build different prototypes. We firmly believe that trial and error are the best elements for achieving great things.

Some parts were made using the 3D printer, the lathe, and the cutter.

EVOLUTION OF THE ROBOT
Our robot went through 3 phases of design and
construction | evolution, | and | in | each | phase, | we
encountered errors or challenges that we had to address, which allowed us to continuously improve the robot.

FIRST EVOLUTION PHASE
Assembly of the “Competition Track”:

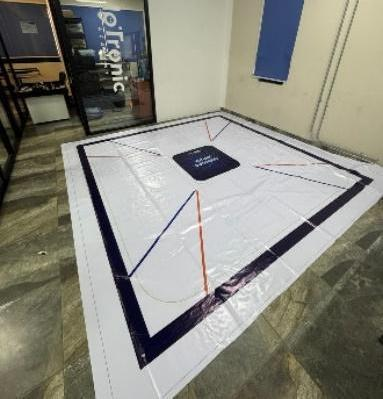
[picture p49: figure]

Although it was difficult to find someone who could print the competition track, we were able to get it printed.

Chassis Design– Mobility Function
Development Features: In this first design version, we used 1 DC motor to control 2 rear wheels and 1 DC motor to control the steering with 2 front wheels. This design resulted in slow speed and poor turning control, so this option was discarded
Version A

SECOND PHASE OF EVOLUTION
Chassis Modification – Mobility Function
Development Features: In this second design version, we used 1 DC motor to control 2 rear wheels and a gear transmission system to improve speed. Additionally, a servo motor was used to control the 2 front wheels. This design improved speed (but with deficiencies in speed control) and enhanced turning control.
Version B

Design of the Structure for the Camera Turning Control Function.
Development Features: A support that holds a gear controlled by a servo motor was integrated. The main idea is that, based on detection, the camera's position can be rotated for greater reach.

THIRD PHASE OF EVOLUTION
Chassis Modification– Mobility Function
Development Features: In this new version, we used 2 DC motors to control the 2 rear wheels and 1 servo motor to control the front wheels. This design improved speed control.
Version C

FOURTH PHASE OF EVOLUTION
Chassis Modification – Mobility Function
Development Features: In this new version, we used 1 DC motor to control the mobility of the 2 front wheels and 1 servo motor to control the turning of the front wheels. This design improved control and ensured compliance with the regulations.
Version D

### 3.3.3. FINAL ASSEMBLY OF THE ROBOT

There are 4 phases for the assembly of the robot.

Phase I – Assembly of the Mobility Management System -Mechanica
Base Mechanical Structure (Chassis)
- Assembly of the robot's base structure

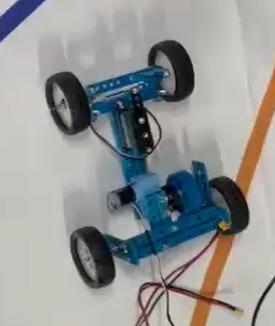
[picture p50: figure]

Complementary Mechanical Structure
- Structure to support the camera, sensors, and front traction.

Phase II – Assembly of the Energy Management System -Electrical
- Installation of the battery

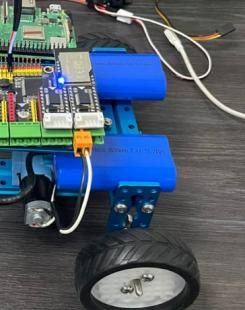
[picture p51: figure]

- Installation of the motors

Phase III - Assembly of the Sensor and Actuator Management System - Electronics
- Installation of the Controller

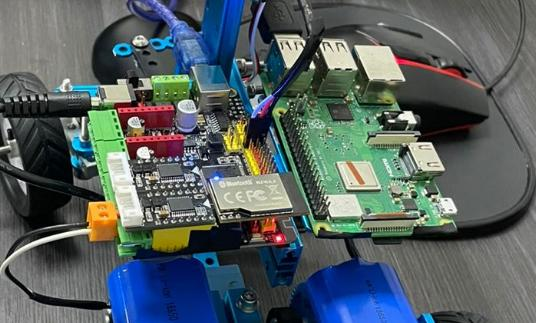
[picture p52: figure]

### 3.3.4. INNOVATION

As a technological innovation, we had to disassemble a motor and change the last gear of the mechanism for a larger gear because we needed to adjust the torque and speed of the robot to improve performance on the competition track.
Below is the motor with 3 gears, and with the last gear larger (38 teeth instead of 24 teeth).

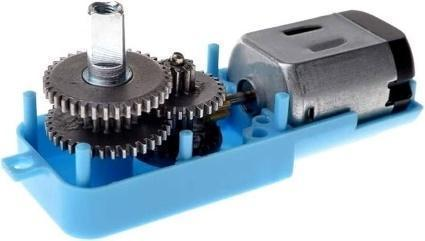
[picture p53: figure]

### 3.3.5. SUMMARY OF PROBLEMS AND SOLUTIONS

During the construction of the Robot we encountered many problems, among which are the following:

Problem: Incorrect detection of traffic signs.
Description: The robot's vision system detected multiple traffic signs simultaneously, which caused confusion in decision making, since it was not able to correctly differentiate between duplicate signs.
Solution: Improve the recognition algorithm so that it identifies and dismisses duplicate signs in the same vision frame. This was achieved by creating a sectorization with pixels and thus avoiding redundancies in decision making.

Problem: Front drive and steering tire coming loose. Description: The front tire, which also provides the robot's drive and steering, would occasionally come loose, disrupting its operation and compromising control. Solution: Reinforce the tire mount using better quality fasteners or a fastening system that prevents loosening. Additionally, industrial adhesives or security screws may be considered to ensure a stronger and longer lasting attachment.

Problem: Excessive power consumption by the camera. Description: The robot's camera consumed a large amount of power, which decreased battery life and limited the robot's operating time.
Solution: Integrate an additional battery dedicated exclusively to the vision components, thus improving the overall autonomy of the robot.

Problem: Insufficient robot travel speed.
Description: The robot had a slow travel speed, which affected its performance in tasks that required agile mobility and short response times.
Solution: Improve the robot's speed by increasing the power of the motors or adjusting the transmission ratio on the gearmotors. Additionally, optimizing the control software can help the robot respond more quickly to travel instructions.

Problem: Limitation in turning due to rear-wheel drive. Description: The rear-wheel drive design caused the robot to make turns that were too wide, making it difficult to maneuver in tight spaces.
Solution: Evaluate the possibility of implementing a front-wheel drive system to improve turning capacity. Alternatively, the turning angle can be adjusted, which will allow a more agile range of movement in small areas.

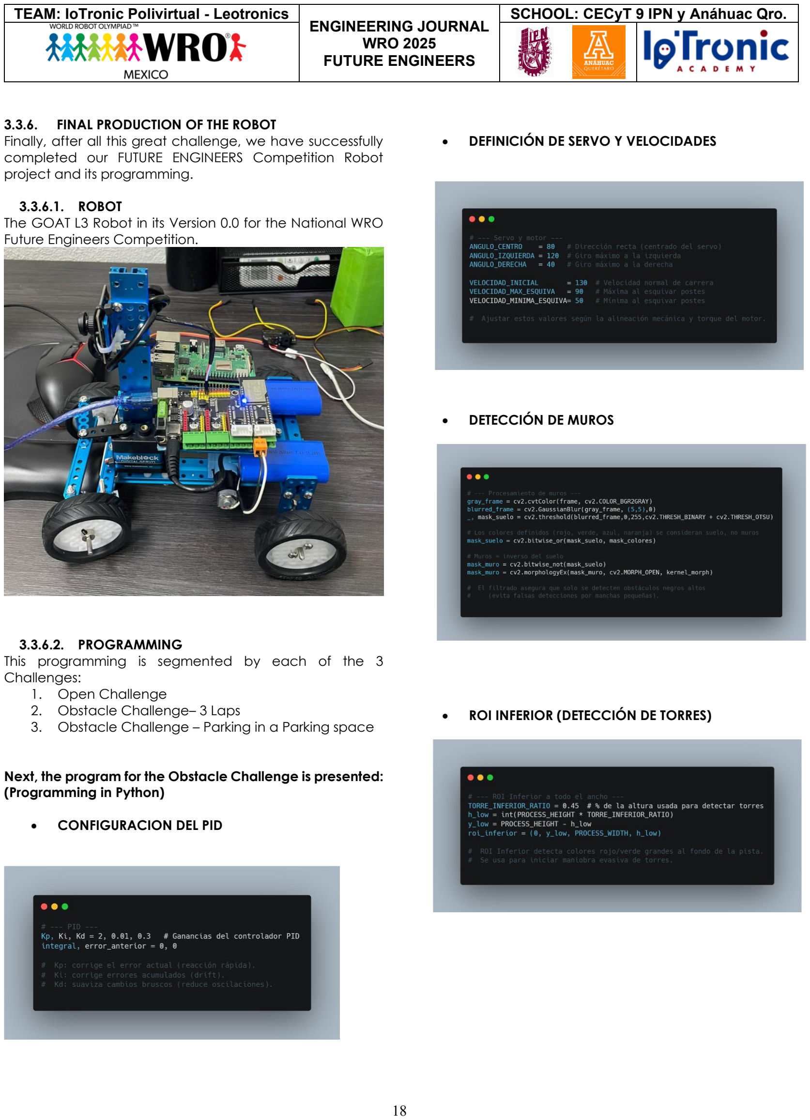
[picture p54: page 19]

### 3.3.6. FINAL PRODUCTION OF THE ROBOT

Finally, after all this great challenge, we have successfully completed our FUTURE ENGINEERS Competition Robot project and its programming.

### 3.3.6.1. ROBOT

The GOAT L3 Robot in its Version 0.0 for the National WRO Future Engineers Competition.

### 3.3.6.2. PROGRAMMING

This programming is segmented by each of the 3 Challenges:
1. Open Challenge
2. Obstacle Challenge– 3 Laps
3. Obstacle Challenge – Parking in a Parking space

Next, the program for the Obstacle Challenge is presented: (Programming in Python)

- CONFIGURACION DEL PID
- DEFINICIÓN DE SERVO Y VELOCIDADES
- DETECCIÓN DE MUROS
- ROI INFERIOR (DETECCIÓN DE TORRES)

- MANIOBRA EVASIVA DE TORRES

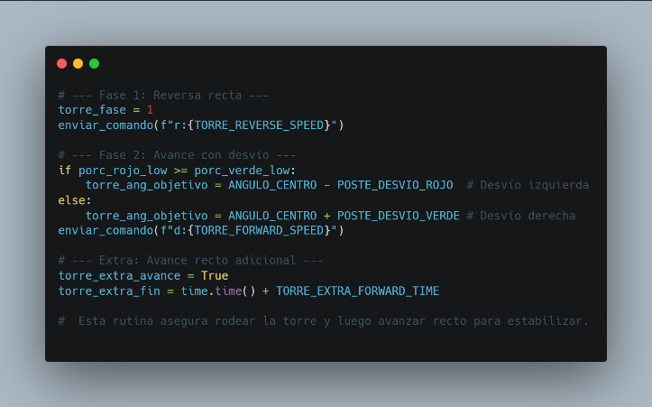
[picture p55: figure]

- HUD DE VISUALIZACIÓN

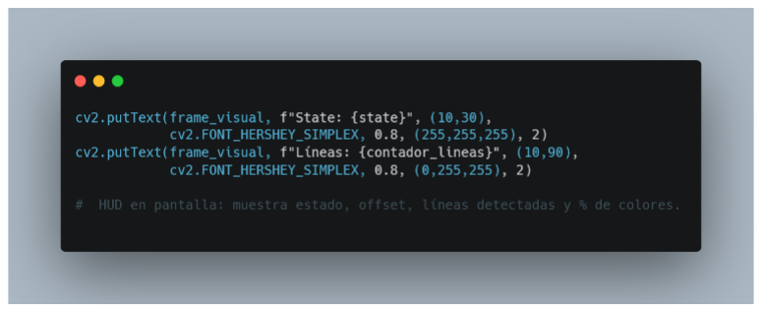
[picture p56: figure]

### 3.3.6.2.1 Distributed Control Architecture

### 3.4. TESTING AND VALIDATION (TESTING)

En este apartado se realizan las Inspecciones Físicas del Robot y las Pruebas.

### 3.4.1. INSPECTION

In the inspection process, a checklist was used that includes the dimensions of the robot, the materials to be used, and the design restrictions. After the inspection, it was deemed that the inspection was satisfactory.

### 3.4.2. TESTING

As a testing plan, it was defined that the following types of tests would be conducted:
- Unit Tests: After completing the construction of each subsystem.
- Operational Tests or Calibration of the Robot: These are functionality tests for each subsystem with the fully finished robot.
- Performance Tests: These are tournament simulation tests, consisting of 3 runs per simulation, and to evaluate performance, 2 simulations are conducted.

It was defined as the Scoring Objective the following:

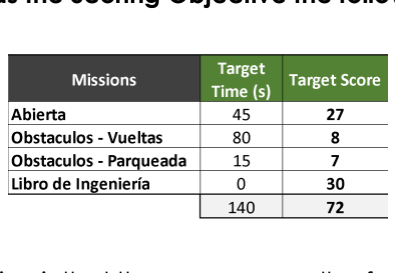
[picture p57: figure]
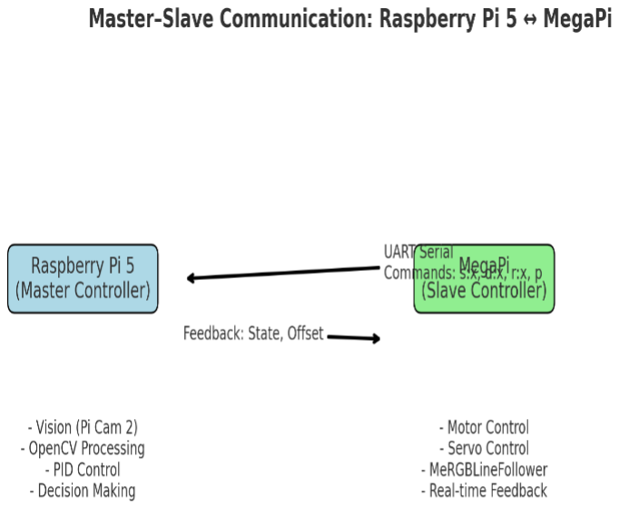
[picture p58: figure]

The first evaluation is that the average results of a simulation should be equal to or greater than 70% of the Scoring Objective.
The second evaluation is that the average of the second simulation should be at least 10% higher than that of the first simulation.

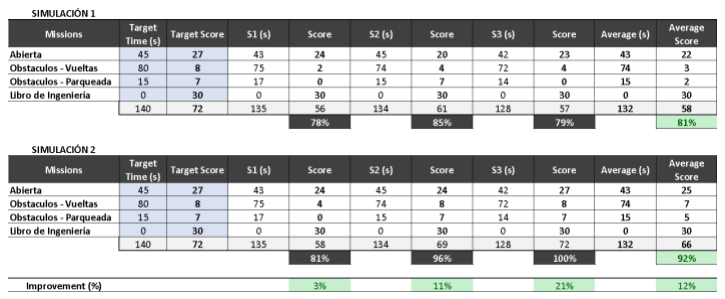
[picture p59: figure]

The performance tests were satisfactory!

### 4. STRATEGIES

The team defined 3 types of strategies to approach the tournament:

After a brainstorming meeting among the team members, we discussed 1. The Competition Rules, 2. Experience in Regional Tournaments, 3. The Experience of the Coaches, and established the following gameplay strategies:
1. Open Challenge Strategies
a) Starting Position
b) Starting Direction
2. Obstacle Challenge Strategies – 3 laps
a) 3 laps in the same direction
b) 2 laps in the same direction and 1 in the opposite direction
c) Parking detection

Development of the Open Challenge Strategies
1 a): Start in a clockwise direction at low speed to ensure compliance with the Challenge. In the final phase, implement the route at high speed.
1 b): Pay attention to the configuration of the program's decision variables in order to execute the route in a counterclockwise direction.

Development of the Obstacle Challenge Strategies
2 a): Start in a clockwise direction at low speed to ensure compliance with the Challenge. In the final phase, implement the route at high speed.
2 b): Pay attention to the configuration of the program's decision variables so that when detecting the last signal, the robot can correctly decide whether the final lap is in the same direction or involves a change of direction.
2 c): After completing the 3 laps, I was able to identify the parking spot and park.

### 5. ACKNOWLEDGEMENTS

To our parents, uncles, and grandparents who supported us and continue to support us in this project, as well as to our Coach and Mentor, and of course to our sponsors, without whom none of this would be possible

We especially thank God for blessing us at all times and for giving us these experiences.

### 6. PHOTOS, VIDEOS AND GITHUB

The | photographic | report, | videos, | and | GitHub
management can be found at the following link. https://github.com/IotronicAcademyhttps://github.com/IotronicAcademy/WRO-Future-Engineers-Mex-2025 (https://github.com/IotronicAcademy/WRO-Future-Engineers-Mex-2025)
